alfkoehn/CO2_monitor/CO2_monitor.pdf

# A CO2 monitor as an introductory microelectronics project helping to slow-down the spread of the corona virus and ensuring a healthy learning and working environment

### A. Köhn-Seemann, alf.koehn@gmail.com

2021-01-27

Abstract

This paper describes the setup of a simple yet reliable CO2 monitor which is based on open-source microelectronics hardware. The monitor is intended to be used in class rooms, lecture halls or offices and can be constructed as a joint students project. It was motivated by recent discussions on the role of aerosols being part of exhaled air to spread the corona virus. The aerosol concentration in air is correlated with the CO2 concentration. Measuring the latter can thus help to slow-down the spread of the corona-virus. The program code used for the CO2 monitor and this documentation is available as a GitHub repository to allow for updates and improvements.

First full version released on 2020-09-22.

License for this document: CC BY-SA 4.0 (https://creativecommons.org/licenses/by-sa/4.0/)

## 1 Introduction

It is generally accepted that the CO2 concentration in a class room has an influence on students’ activities, their ability to study and learn [1, 2], or on their health and thus attendance [3]. The same applies of course to office environments [4]. The major source of CO2 in a class room is the exhaled air of the students (and teachers) [5]. It thus increases over time but can also be relatively easy controlled by proper ventilation. Monitoring

1

the CO2 concentration over time provides thus a simple way to ensure a productive and healthy learning environment.
In addition to CO2 , exhaled air consists of aerosols (among other things). It is now generally accepted that the aerosols of patients being infected with SARS-CoV-2, might contain viable virus concentrations which are large enough to cause further infections if somebody else inhales those aerosols [6– 9]. Note that this seems to happen even if the infected patients show no symptoms of SARS-CoV-2 [10] or not yet any symptoms [11]. It is thus not surprising that the vast majority of SARS-CoV-2 virus transmissions seems to happen indoors [12] and that closing schools and universities, for example, were found to have a significant effect on the spread of the virus [13]. Face masks can help to reduce the aerosol outflow and thus also slow down the infection rates [14, 15].
With half-life periods of the virus on aerosols on the order of 1 hour [16], it becomes evident that proper ventilation, strongly reducing the aerosol concentration, can help to prevent hidden infections, i.e. infections where the infected person is not (yet) aware of their infection but already contagious. This is further stressed by a case study from a seafood market in south China [17], a restaurant also from China [18], or from a choir in the US [19]. Note that ventilation was already recommended as a proper measure against the spread of a different pandemic, the Spanish flu, more than 100 years ago [20].
Since aerosols and CO2 are both parts of exhaled air, measuring the CO2 concentration in a room provides an easy accessible indicator for the aerosol concentration [21, 22]. In recent recommendations from national authorities, it was suggested to use the CO2 concentration as an indicator when ventilation is required [23–25]. A relevant example for the positive effect of proper ventilation based on the CO2 concentration in a room is the stopping of a tuberculosis outbreak at the Taipei University in Taiwan: only after the air circulation in every room was improved such that the CO2 concentration stayed around 600 ppm (the outdoor value is approximately 400 ppm), the outbreak came to a halt and stopped completely [26].
While commercial CO2 monitors do exist [27–29], these might be considered too expensive for usage in large quantities in schools or universities and/or currently have long delivery times (since their potential help in slowing down the spread of the SARS-CoV-2 virus seems to become more and more accepted). Here we present a simple and cost effective, yet reliable way to monitor the CO2 concentration. Widely available microelectronic components are used which can be easily programmed via open source software platforms allowing to modify and extend the examples presented in this paper. Students can build the detectors in class as a joint project which might

2

serve to raise interest in electronics or the underlying physical and chemical processes [30].
This work was inspired by a project of the Hochschule Trier [31], where the design and construction of a CO2 measuring device is suggested as a students’ project, allowing to discuss a variety of scientific topics during the course of the project. In addition, a few posts from different forums served as an inspiration [32–35]. Furthermore, a small number of projects hosted and maintained as GitHub repositories and webpages using the same CO2 detector are available [36–39]. We would like to recommend the interested reader in particular to the repository by paulvha [38] as it contains a rather large number of examples and to an article published in the Make Magazin [40] which contains a full description including the assembly of a CO2 monitor similar to the one presented in this paper.

## 2 The CO2 monitor

The CO2 monitor is based on the microelectronic sensor SCD30 which measures the CO2 concentration and also provides measurements of the ambient temperature and relative humidity [41]. Using Arduino as a programing language and some microcontroller, it is straightforward to get the sensor running and outputting data, thanks to the examples available in the libraries provided by SparkFun [42]. Using the Arduino IDE [43], which is available for all major operating systems, the corresponding libraries can be simply included via the library manager.
To make the CO2 monitor visually appealing, we decided to output the measurement to an OLED display (which is inexpensive and available in a large variety of sizes and configurations). Due to the widespread usage of such displays, they can also be directly included via the library manager in the Arduino IDE. Alternatively, an LCD display can be used which has the advantage of being larger in diameter but having a reduced resolution at a similar price. Note that we recommend to use LCD-displays with I2Cmodules to make the wiring and/or soldering less complicated (connecting 4 cables instead of 16).
In addition to just showing some numbers, we have included a red LED at the prototype installation which lights up as soon as some threshold value of the CO2 concentration is reached, indicating the need for ventilation. One could also think of a traffic light design, where first a yellow LED lights up at a slightly lower threshold value. The Federation of European Heating, Ventilation and Air Conditioning associations (REHVA) recommends to issue a warning, corresponding to an orange light, when a value of 800 ppm is

3

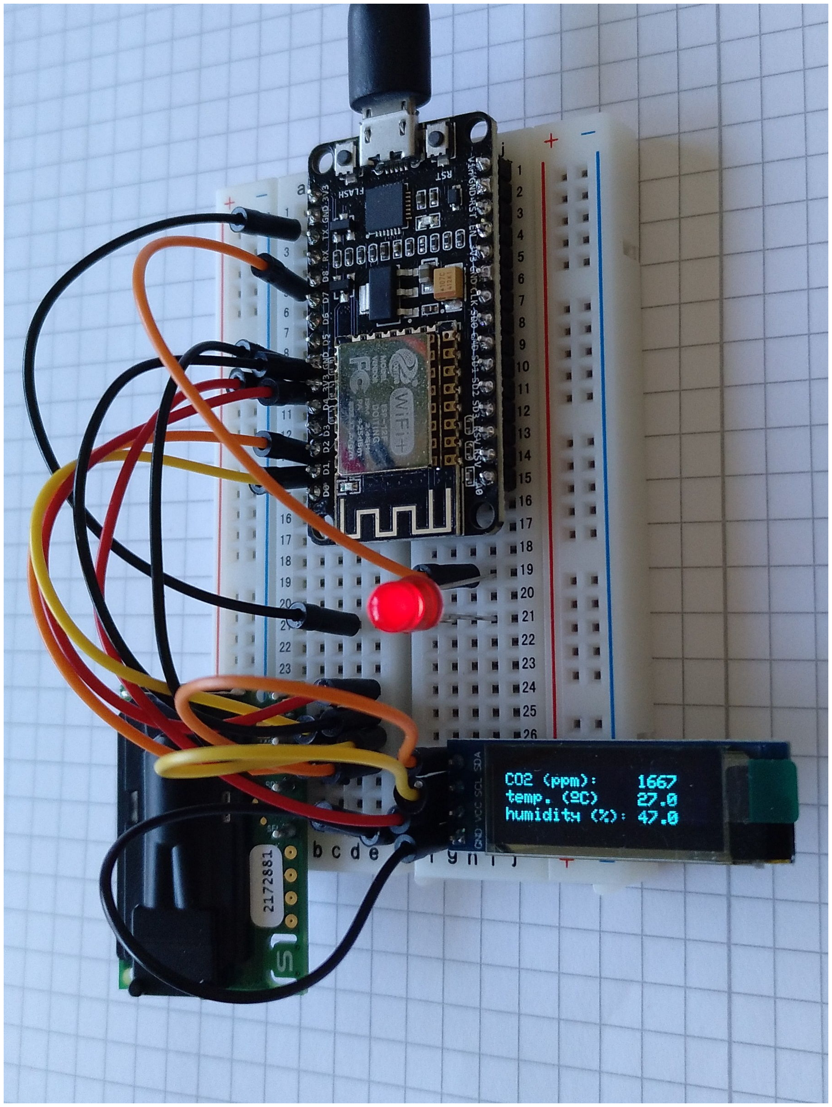
[picture p1: figure]
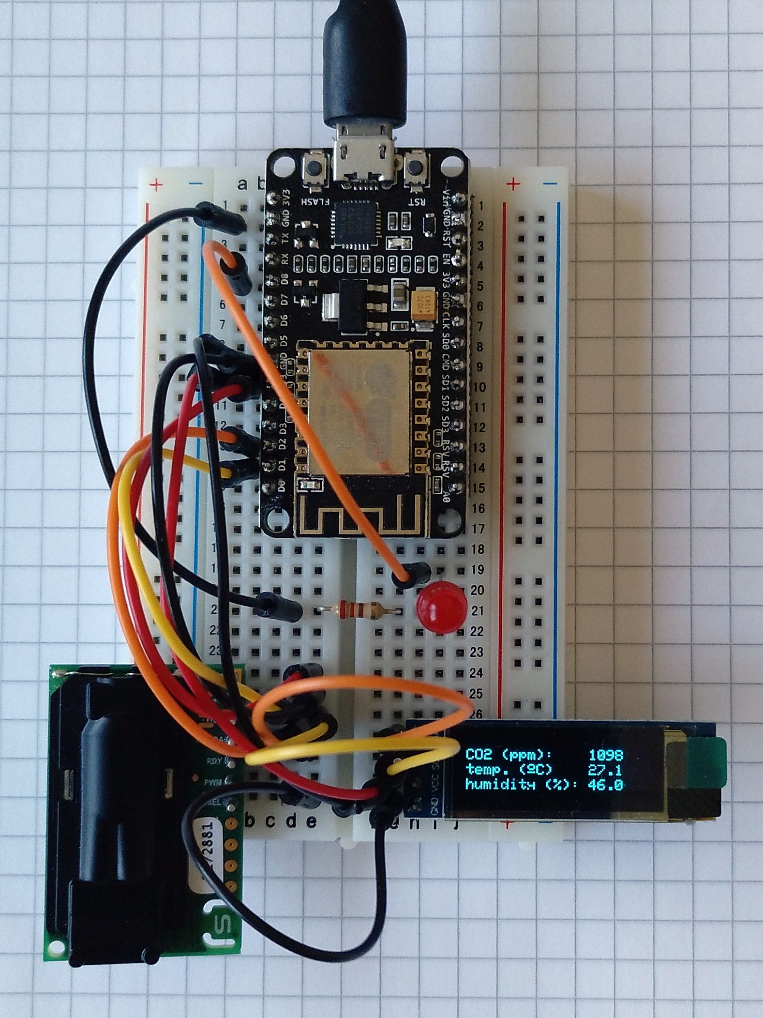
[picture p2: figure]

Figure 1: Assembled and working prototype of the CO2 monitor, (left) with a measured CO2 concentration below the threshold and (right) above it (note the red LED).

reached and prompt to trigger some action like ventilation, corresponding to a red light, when 1000 ppm are reached [44]. The Federal Ministry of Labour and Social Affairs of Germany also states a threshold value of 1000 ppm that should not be passed [45]. Note that a value of approximately 410 ppm is the typical CO2 concentration of fresh air [46].
As a microcontroller we decided to use the low-cost open source NodeMCU ESP8266 board [47], as it offers enough flexibility to further extend the functionality of the CO2 monitor. Of particular interest might be the WiFi capability allowing for example to write the measured values to a web-server where they can then be accessed via a web-browser or an app on a smartphone.
A prototype of the CO2 monitor is shown in Fig. 1. As one can see, it is not enclosed in some box to still allow easy access for modifications. The idea of this prototype was rather to show that the general principle of the CO2 monitor is working and not to provide a polished final product. The prototype is ready to be used in a class room or lecture hall, although it might be worth to mount everything into a box which is not only visually more appealing but provides also some protection.
As a next step one might want to replace the breadboard by a stripboard which of course requires some soldering but results in a more robust device.

4

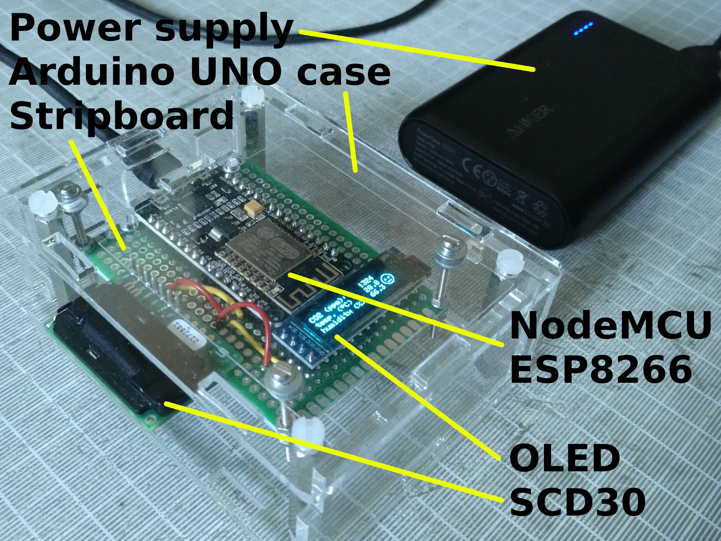
[picture p3: figure]

Figure 2: Assembled CO2 monitor, version 2. Note the usage of a stripboard and a casing originally designed for an Arduino Uno. In addition to the actual value, the CO2 concentration is indicated by the happiness of a smiley face shown next to the numbers on the OLED display.

Instead of designing a case for the CO2 monitor, it is possible to use cases which were originally designed for a Raspberry Pi or an Arduino Uno. Furthermore, the LEDs as an indicator for the level of the CO2 concentration can be replaced by a smiley face on the OLED display whose happiness correlates with the CO2 concentration: a higher level results in a more sad face. Figure 2 shows a photography of such an assembly, referred to as CO2 monitor version 2. More details about different assembly variations are discussed in Section 5.

### 2.1 Positioning in a room

The CO2 monitor should be placed at a position in a room where it is not exposed to flowing air as this would distort the measured CO2 concentration (see Section 4). This means that it should, for example, not be placed inbetween a window and a door if both are used for efficient cross ventilation¹ .

1Altough cross ventilation is more efficient than impact ventilation (“querlüften” vs. “stoßlüften” [48]) one has to take care that behind the open door in Fig. 3 another open window is needed otherwise one could release part of the classroom air and its potentially

5

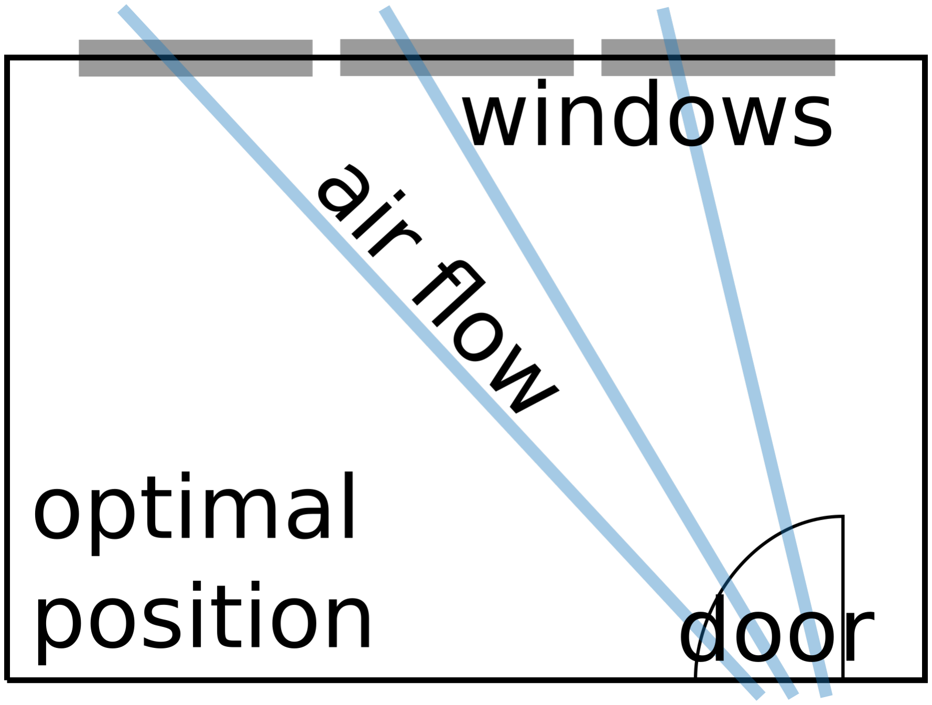
[picture p4: figure]

Figure 3: Optimal position of the CO2 monitor in a room where ventilation by an air flow across the room (cross ventilation) can be applied.

Figure 3 indicates the optimal positioning in such a situation. It should also not be positioned too close to the students’ or teachers’ heads as they could temporarily trigger very high values being displayed on the CO2 monitor if directly exhaling onto it. A position slightly above everybody’s head seems to be best as this would also allow everybody to have a look at it. The latter fact could in principle lead to some students’ closely following every change on the CO2 monitor instead of paying attention to the class or lecture. An easy solution would be to show only CO2 concentrations rounded to 100 ppm, for example print “CO2 in 100 ppm: 8” to a display [49].
Also be aware that classrooms and lecture halls often provide only a small number of wall sockets. One would thus need either a long enough power cable or a power bank (USB charger) which can also be included in the case of the CO2 monitor itself.

## 3 Required parts

The CO2 monitor as presented here consists of a number of parts for which it is not important to use the exact same model. The only component which should not be replaced is the CO2 measuring device, the SCD30. Note that the program code discussed in Sec. 6 is tailored for the NodeMCU ESP8266, replacing that component would thus require small adjustments to the code. The parts used for the prototype of the CO2 monitor are listed in Table 3. The display can be easily replaced by an OLED of larger size. One could also

infectious aerosols into the corridor which connects different classrooms or lecture halls [49].

6

Element | Quantity Price
SCD30 (CO2 sensor) | 1 | 45 e
NodeMCU ESP8266 | 1 | 5 e
0.91⁰⁰ OLED display | 1 | 5 e
red LED | 1 | 0.2 e
220 Ω resistor | 1 | 0.1 e
mini breadboard | 1 | 4 e
breadboard cables | 10 | 4 e
pin header | 1 | 0.5 e
micro USB cable | 1 | 3 e

Table 1: Components used for the CO2 monitor as presented in this paper (note that the prices were obtained in 09/2020 and may vary).

use multiple displays, which would require to take care of proper addressing the displays and thus add a little bit of complexity to the code (and to the assembly).
The usage of a breadboard was motivated by educational purposes as this allows very easy assembly without the need to solder anything. It can, however, directly be replaced by a stripboard or completely omitted and use only cables or pin headers (which would require some soldering).
Note that the prices as listed in the table can be pushed down (significantly for some of the components) when ordering larger quantities.
For the prototype design of the CO2 monitor we have decided to leave out a proper casing. One could either use a standard-sized case, or design one and print it for example on a 3D printer or re-use/recycle some old boxes. It is however important to correctly position the SCD30 inside the box: as described in a manufacturer’s document [50], the sensor is ideally placed as close as possible to the box’s outer shell and to a large opening to be properly exposed to the ambient. The box should be as small as possible to get fast response times to changes in the ambient air. The SCD30 should also be isolated from direct air flow, as the corresponding changes in pressure (due to the air flow) would lead to increased noise and thus reduced accuracy in the measurements. It is also recommended to not directly place the sensor above heat sources like for example microcontrollers.

## 4 The CO2 sensor

The SCD30 has been chosen because it performs direct measurements of the CO2 concentration. Cheaper sensors often measure the concentration

7

of volatile organic compounds (VOC) and then assume a correlation between the two quantities. This can, however, lead to wrong values of the CO2 concentration since VOC can be emitted from a variety of chemicals. Although VOCs are also known to cause health problems, here we are explicitly interested in the CO2 concentration, as discussed in Sec. 1. For a discussion about monitoring VOC and CO2 concentration with self-assembled devices we would like to point the interested reader to e.g. Ref. [51].

### 4.1 Technical specifications

According to the datasheet of the SCD30 [41], the CO2 sensor has a measurement range of 0−40, 000 ppm with an accuracy of ±30 ppm. The supply voltage needs to be between 3.3 and 5 V which allows to use a variety of microcontrollers. The drawn current is specified to be on average 19 mA with a maximum value of 75 mA. With a sensor lifetime of 15 years, the SCD30 offers a reliable system to permanently monitor the CO2 concentration.

### 4.2 Nondispersive infrared technique

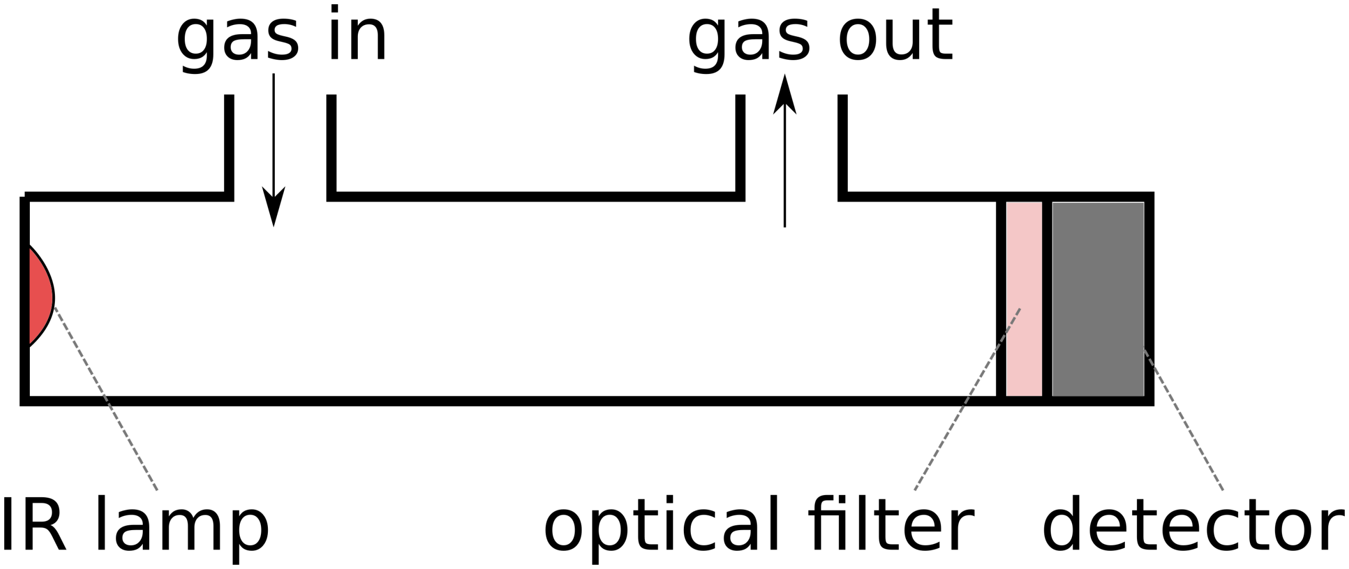
[picture p5: figure]

Figure 4: Sketch of a sensor using the nondispersive infrared technique to measure CO2 concentration.

The CO2 concentration is measured using the so-called nondispersive infrared technique (NDIR) which is the most common sensor type used in industry to measure the CO2 concentration [52–54]. Its principle is sketched in Fig. 4. A light source (a light bulb is used here) emits infrared light which travels through a tube filled with a sample of the surrounding air. The spectrum of the emitted light includes the 4.26 µm absorption band of CO2 which is unique to the typical components of air and the light is absorbed by them. At the end of the tube, the remaining light hits an optical filter that allows only that specific wavelength of 4.26 µm to pass. A CMOS detector then collects the remaining light and measures its intensity I1. The difference

8

between the intensity of light emitted by the source I0 and received by the detector at this specific wavelength is due to the CO2 molecules in the tube which then allows to calculate the CO2 concentration using the Beer-Lambert law:
I1 = I0e

−κCl
, | (1)

where κ is the absorption coefficient of CO2 , C its concentration, and l the length of the tube. A second tube without the optical filter in-front of the CMOS detector is used as a reference tube to compensate variations of I0. Using folded optics, i.e. waveguides, for the tube allows for a very compact size of the overall sensor on the order of just a few centimeters.

### 4.3 Calibration

The SCD30 is sold as a fully calibrated sensor and thus requires in principle no calibration before its usage. According to the manual [55], the sensor is set to automatically perform a self-calibration. This requires, however, to expose the sensor to fresh air on a regular basis. In particular during the first 7 days of operation, it has to be exposed to fresh air for one hour every day [55]. Since this is a requirement which is unrealistic to fulfill for our use case, we decided to follow a different approach: instead of the automatic self-calibration (ASC), a forced recalibration (FRC) can be performed after triggering it by the user. According to our observations, the SCD30 shows only very little drift over time, such that an FRC is only required once or twice per year (or after installing the SCD30 sensor into some device as it might have experienced some mechanical stress).
To perform the FRC, the CO2 monitor simply needs to be placed outside somewhere where it is exposed to fresh air. Note that the sensor itself should not experience strong winds as this would deteriorate the measurements. The whole sensor should be in thermodynamic equilibrium before starting the FRC so it is best to operate it for a time of approximately 10 min before starting the FRC (for more details about the code, see Section 6).

## 5 Assembly

The CO2 monitor can be assembled in various ways, first we will restrict ourselves to the case of a simple prototype design on a breadboard as shown in Fig. 5. The connection between the NodeMCU (with the ESP8266) and the SCD30 sensor is as follows:

9

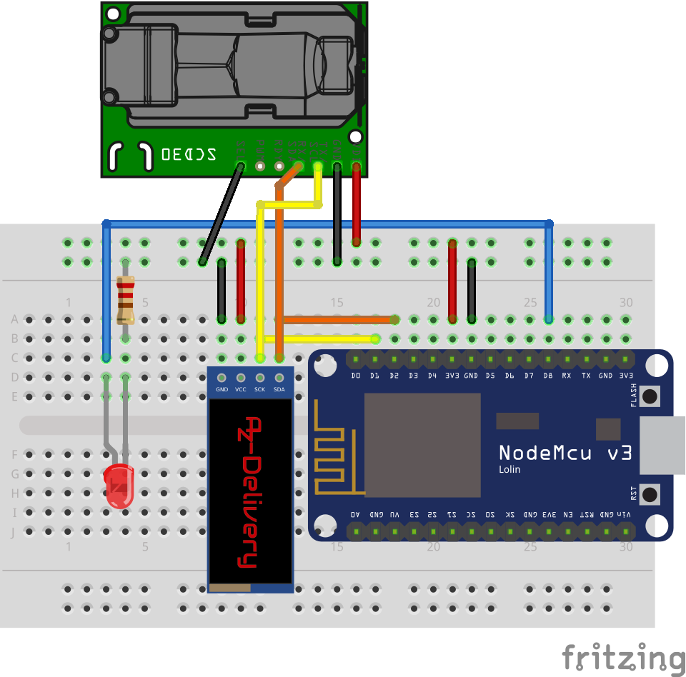
[picture p6: figure]

Figure 5: Schematic of a prototype of the CO2 monitor (version 1).

NodeMCU | SCD30
GND | −→ GND
3.3 V −→ VIN
D2/GPIO4 −→ RX/SDA
D1/GPIO5 | −→ TX/SCL
GND | −→ SEL

The NodeMCU ESP8266 board then needs to be connected to the OLED display as follows:

NodeMCU | OLED display
GND | −→ GND
3.3 V −→ VCC
D2/GPIO4 −→ SDA
D1/GPIO5 −→ SCL

It is of course also possible to directly connect the respective SDA and SCL pins of the OLED and the SCD30, as shown in Fig. 5, instead of connecting those pins between the SCD30 and the NodeMCU. The red LED is connected with its anode, the longer leg, to pin D8/GPIO15 of the NodeMCU and with its cathode, the shorter leg, via a 220 Ω resistor (to limit the current) to ground.
As discussed in Section 2, different assemblies of the CO2 monitor are

10

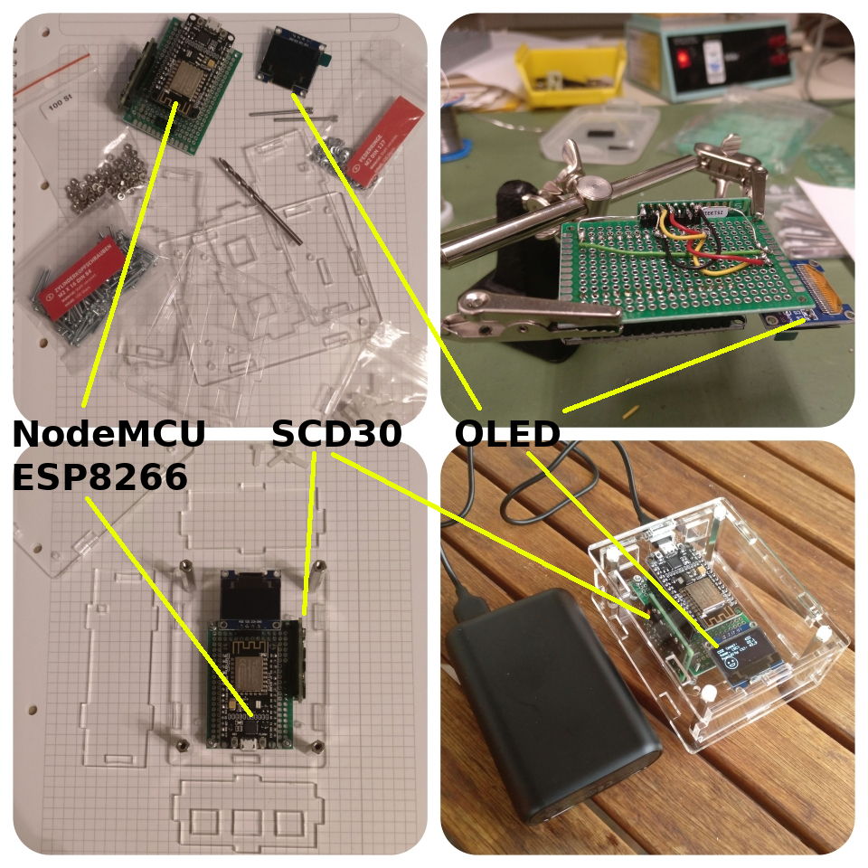
[picture p7: figure]

Figure 6: CO2 monitor, version 3, in various stages of the assembly process. As compared to version 2, see Fig. 2, a larger OLED display is used, the SCD30 is mounted in a different way, and a slightly smaller stripboard is used.

possible. Figure 6 shows what we refer to as version 3 in various stages of the assembly process. Compared to version 2, a larger OLED display is used, which requires to updates its size at the beginning of the program code, see Listing 3. As can be seen, the breadboard from version 1 is replaced by a stripboard onto which the necessary components need to be soldered. The casing is the same as in version 2 (which was originally intended to be used for an Arduino Uno). The side wall closest to the SCD30 has been omitted to ensure that the gas atmosphere inside the casing is the same as outside (a few holes drilled into that wall should have had the same effect). A portable battery charger, a power bank, is used as a power supply allowing for mobile usage of the CO2 monitor across the day.
A different assembly is shown in Fig. 7, where a picture frame and an

11

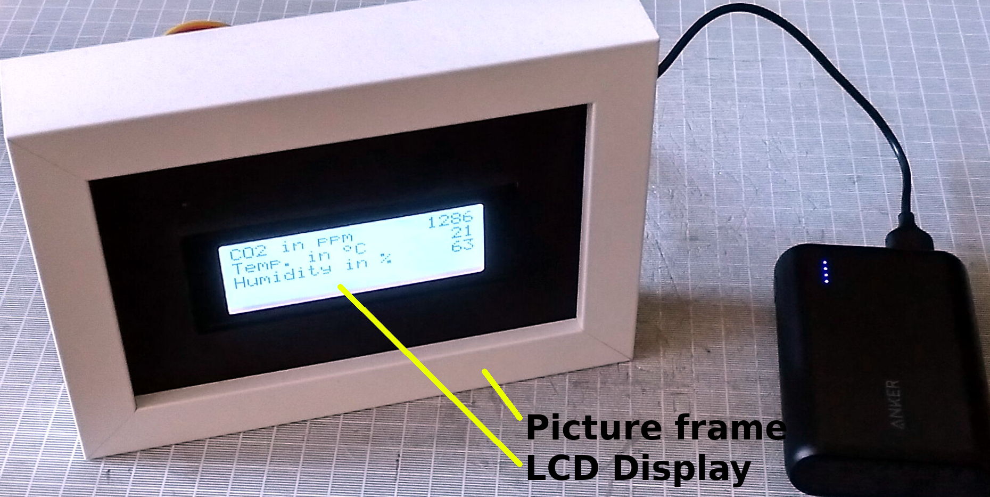
[picture p8: figure]

Figure 7: CO2 monitor, version 4. As compared to version 2 and 3, see Figs. 2 and 6, an LCD display is used which and mounted in a picture frame which allows to hide the other electronics due to its thickness of several centimeters.

4-row LCD display is used. The picture frame comes at a price of approximately 2 e and the LCD display is available at this size for approximately 10 e. The thickness of the picture frame allows to mount the other electronic components in it resulting in a visually appealing device. The finite thickness also allows to simply put the picture frame on a table/desk (or any other flat surface).

## 6 The program code

Arduino is used as programming language in this project due to its widespread usage and large numbers of libraries available for various hardware components. The Arduino IDE library manager allows to directly install a proper Arduino library for the SCD30. Alternatively, the library is available as a GitHub repository [42]. For a tutorial on how to install libraries within the Arduino IDE, see Ref. [56]. As for the NodeMCU and the OLED display, the Arduino IDE library manager is able to provide the required libraries. The source code for the CO2 monitor as described in this paper is available on GitHub [57], in order to be able to update and extend it. Nevertheless, we have also included the code in this paper, to provide a complete description of the project. At the very beginning of the code, some switches are set defining the general behavior of the program, as can be seen in Listing 1.

1 | // - - - - - - - - - - - - - - - - - - - - - - - - - - - - - - - - - - - - - - - - - - - - - - - - - - - - - - - - - - - - - - - - - - -
2 | // Some switches defining general behaviour of the program
3 | // - - - - - - - - - - - - - - - - - - - - - - - - - - - - - - - - - - - - - - - - - - - - - - - - - - - - - - - - - - - - - - - - - - -

12

4 | # define WIFI_ENABLED false | // set to true if WiFi is desired ,
5 | // otherwise c or re spo nd in g code is not
compiled
6 | #if WIFI_ENABLED
7 | # define WIFI_WEBSERVER true | // website in your WiFi for data and data
logger
8 | # define WIFI_MQTT false | // activate MQTT integration in your WiFi
9 | # endif
10 | # define DEBUG true | // activate debugging
11 | // true : | print info + data to serial
monitor
12 | // false : serial monitor is not used
13 | # define DISPLAY_OLED | // OLED display
14 | //# define DISPLAY_LCD | // LCD display
15 | # define SEND_VCC false
16 | // - - - - - - - - - - - - - - - - - - - - - - - - - - - - - - - - - - - - - - - - - - - - - - - - - - - - - - - - - - - - - - - - - - -
Listing 1: General behavior of the program is set via some switches.

The include statements to import the required libraries are shown in Listing 2. The Adafruit GFX.h and Adafruit SSD1306.h libraries are used for an OLED display (if one is connected) and are required to be installed via the library manager of the Arduino IDE beforehand (alternatively, they are also available on GitHub [58] for manual installation). The LiquidCrystal I2C.h library is used for the LCD display (if one is connected) and is also required
to be installed via the library manager (or directly from GitHub [59]). Note that the OLED and/or LCD display size needs to be set correctly and can vary. The SparkFun SCD30 Arduino Library.h also needs to be installed via the library manager (or manually from the GitHub repository [42]).
1 | // - - - - - - - - - - - - - - - - - - - - - - - - - - - - - - - - - - - - - - - - - - - - - - - - - - - - - - - - - - - - - - - - - - -
2 | // Import all required libraries
3 | // - - - - - - - - - - - - - - - - - - - - - - - - - - - - - - - - - - - - - - - - - - - - - - - - - - - - - - - - - - - - - - - - - - -
4 | # include < Wire .h > | // for I2C c om mu nic at io n
5 | # ifdef DISPLAY_OLED
6 | # include < Adafruit_GFX .h > | // for writing to display
7 | # include < Adafruit_SSD1306 .h > | // for writing to display
8 | # endif
9 | # ifdef DISPLAY_LCD
10 | # include < LiquidCrystal_I2C .h >
11 | # endif
12 | # include " SparkFun_SCD30_Arduino_Library .h"

13
14 | # include < ESP8266WiFi .h > | // also allows to explicitely turn WiFi
off
15 | #if WIFI_ENABLED
16 | #if WIFI_WEBSERVER
17 | # include < Hash .h > | // for SHA1 algorith ( for Font Awesome )
18 | # include < ESPAsyncTCP .h >
19 | # include < ESPAsyncWebServer .h >

20
21 | # include " Webpageindex .h" | // webpage content , same folder as . ino
file
22 # endif

23
24 #if WIFI_MQTT

13

25 | # include < PubSubClient .h > | // allows to send and receive MQTT
messages

26
27 | // add local MQTT server IP here .
28 | IPAddress mqttserver (192 , 168 , 1, 100) ;
29 | # endif
30 | // Replace with your network credentials
31 | const char * ssid | = " ENTER_SSID ";
32 | const char * password | = " ENTER_PASSWORD ";
33 | const char * deviceName = " ENTER_ESP_DEVICE_NAME ";
34 | # endif
35 | // - - - - - - - - - - - - - - - - - - - - - - - - - - - - - - - - - - - - - - - - - - - - - - - - - - - - - - - - - - - - - - - - - - -
Listing 2: Load required libraries.

A switch is included in the header of the code allowing to enable or disable WiFi capabilities (by setting the variable WIFI ENABLED respectively to true or false). The libraries required for using WiFi are only included if the corresponding switch is set to true. In this example, we decided to use the ESPAsyncWebServer [60], based on ESPAsyncTCP [61], for a webserver supposed to run on the ESP8266 because asynchronous networks, as provided by these two libraries, allow us to handle more than just one connection at a time (which is important if used in a classroom environment). During the time of writing this article, these libraries require manual installation, i.e. getting a zip file from the GitHub repositories and include those zip files manually as libraries in the Arduino IDE.
Hardware configurations, including the size of the display used, and some global constants are set after the include statements, as shown in Listing 3.
1 | // - - - - - - - - - - - - - - - - - - - - - - - - - - - - - - - - - - - - - - - - - - - - - - - - - - - - - - - - - - - - - - - - - - -
2 | // Hardware c o n f i g u r a t i o n s and some global constants
3 | // - - - - - - - - - - - - - - - - - - - - - - - - - - - - - - - - - - - - - - - - - - - - - - - - - - - - - - - - - - - - - - - - - - -
4 | # define CO2_THRESHOLD1 600
5 | # define CO2_THRESHOLD2 1000
6 | # define CO2_THRESHOLD3 1500

7
8 | # define WARNING_DIODE_PIN D8 | // NodeMCU pin for red LED

9
10 | # define MEASURE_INTERVAL 10 | // seconds , minimum : 2

11
12 | # define SCREEN_WIDTH 128 | // OLED display width in pixels
13 | # define SCREEN_HEIGHT 32 | // OLED display height in pixels

14
15 | const int lcdColumns | = 20; | // LCD : number of columns
16 | const int lcdRows | = 4; | // LCD : number of rows

17
18 | # define OLED_RESET LED_BUILTIN | // OLED reset pin , 4 is default
19 | | | // -1 if sharing Arduino reset pin
20 | | | // using NodeMCU , it is LED_BUILTIN

21
22 | const float TempOffset = 5; | // temperature offset of the SCD30
23 | | | // 0 is default value
24 | | | // 5 is used in SCD30 - library example
25 | | | // 5 also works for most of my devices

26

14

27 | const int altitudeOffset = 300; | // altitude of place of operation in
meters
28 | // Stuttgart : approx 300; Uni Stuttgart :
approx 500; Lohne : 67

29
30 | // update scd30 readings every M E A S U R E _ I N T E R V A L seconds
31 | const long interval = MEASURE_INTERVAL *1000;

32
33 | // use " unsigned long " for variables that hold time
34 | // | --> value will quickly become too large for an int
35 | // store last time scd30 was updated
36 | unsigned long previousMilliseconds = 0;

37
38 | // switch to perform a forced re ca li br at io n
39 | // should only be done once in a while and only when outside
40 | bool DO_FORCED_RECALIBRATION = false ;
41 | // - - - - - - - - - - - - - - - - - - - - - - - - - - - - - - - - - - - - - - - - - - - - - - - - - - - - - - - - - - - - - - - - - - -
Listing 3: Set some configurations.

Due to the complexity of the code, we decided to encapsulate certain parts in separate functions and use the technique of function prototyping and declaration. The function prototypes are shown in Listing 4.

1 | // - - - - - - - - - - - - - - - - - - - - - - - - - - - - - - - - - - - - - - - - - - - - - - - - - - - - - - - - - - - - - - - - - - -
2 | // Function prototypes ( not needed in Arduino , but good practice imho )
3 | // - - - - - - - - - - - - - - - - - - - - - - - - - - - - - - - - - - - - - - - - - - - - - - - - - - - - - - - - - - - - - - - - - - -
4 | void airSensorSetup () ;
5 | void forced_recalibration () ;
6 | void printToSerial ( float co2 , float temperature , float humidity );
7 | # ifdef DISPLAY_OLED
8 | void printToOLED ( float co2 , float temperature , float humidity );
9 | void printEmoji ( float value );
10 | # endif
11 | # ifdef DISPLAY_LCD
12 | void printToLCD ( float co2 , float temperature , float humidity ) ;
13 | void scrollLCDText ( int row , String message , int delayTime );
14 | # endif
15 | // - - - - - - - - - - - - - - - - - - - - - - - - - - - - - - - - - - - - - - - - - - - - - - - - - - - - - - - - - - - - - - - - - - -
Listing 4: Function prototypes.

Following the function prototypes, hardware declarations are executed, as shown in Listing 5.

1 | // - - - - - - - - - - - - - - - - - - - - - - - - - - - - - - - - - - - - - - - - - - - - - - - - - - - - - - - - - - - - - - - - - - -
2 | // Hardware declarations
3 | // - - - - - - - - - - - - - - - - - - - - - - - - - - - - - - - - - - - - - - - - - - - - - - - - - - - - - - - - - - - - - - - - - - -
4 | # ifdef DISPLAY_OLED
5 | // Declaration for an SSD1306 display connected to I2C (SDA , SCL pins )
6 | Adafruit_SSD1306 display ( SCREEN_WIDTH , SCREEN_HEIGHT , & Wire , OLED_RESET );
7 | # endif
8 | # ifdef DISPLAY_LCD
9 | // run I2C scanner if LCD address is unknown
10 | LiquidCrystal_I2C lcd (0 x27 , lcdColumns , lcdRows );
11 | # endif

12
13 | SCD30 airSensor ;
14 | // - - - - - - - - - - - - - - - - - - - - - - - - - - - - - - - - - - - - - - - - - - - - - - - - - - - - - - - - - - - - - - - - - - -

15

Listing 5: Hardware declarations.

To display the values measured by the SCD30 sensor on a website, we use global variables in the code, as shown in Listing 6. The complete html code for the website is loaded via including it as a library.

1 | #if WIFI_ENABLED
2 | // temperature , humidity , CO2 for web - page , updated in loop ()
3 | float temperature_web = 0.0;
4 | float humidity_web | = 0.0;
5 | float co2_web | = 0.0;

6
7 | #if WIFI_WEBSERVER
8 | // create A s y n c W e b S e r v e r object on port 80 ( port 80 for http )
9 | AsyncWebServer server (80) ;
10 | # endif
11 | #if WIFI_MQTT
12 | // declare ( initialize ) object of class WiFiClient (to establish
connection to IP/ port )
13 | WiFiClient espClient ;
14 | // declare ( initialize ) object of class PubSubClient
15 | // input : constructor of previously defined WiFiClient
16 | PubSubClient mqttClient ( espClient ) ;
17 | // message to be published to mqtt topic
18 | char mqttMessage [10];
19 | # endif
20 | # endif
Listing 6: Prepare website.

The code for the webpage itself is shown in Listing 7.

1 | //
2 | // PROGMEM stores data in flash memory , default is storing in SRAM
3 | // | --> usually , only worth to be used for large block of data
4 | // R infront of string indicates a RAW string literal
5 | // | --> no need to escape linebreaks , quotationmarks etc .
6 | // | --> allows to put full html - website into variable
7 | // | --> beginning and end of RAW string literal indicated by
8 | // | =====( ... ) =====
9 | //
10 | const char MAIN_page [] PROGMEM = R" =====(
11 | <! doctype html >
12 | <html >

13
14 | <head >
15 | <title >CO2 Monitor </ title >
16 | <!- - very helpful reference : https :// www . w3schools . com -->
17 | <meta charset ="utf -8">
18 | <!- - make webpage fit to your browser , not matter what OS or browser ( also
adjusts font sizes ) -->
19 | <meta name =" viewport " content =" width = device - width , initial - scale =1">
20 | <!- - prevent request on favicon , otherwise ESP receives favicon request
every time web server is accessed -->
21 | <link rel=" icon " href =" data :,">
22 | <!- - load Font Awesome , get integrity and url here : https :// fontawesome .
com / account / cdn -->

16

23 <link rel=" stylesheet " href =" https :// use . fontawesome . com / releases / v5 .14.0/ css / all . css " integrity ="sha384 - HzLeBuhoNPvSl5KYnjx0BT + WB0QEEqLprO + NBkkk5gbc67FTaL7XIGa2w1L0Xbgc " crossorigin =" anonymous ">
24 <!- - load chart .js library , this could also copied to esp8266 for usuage without internet connection -->
25 <script src = " https :// cdnjs . cloudflare . com / ajax / libs / Chart . js /2.7.3/ Chart . min . js" ></ script >
26 | <style >
27 | canvas {
28 | -moz -user - select : none ;
29 | -webkit -user - select : none ;
30 | -ms -user - select : none ;
31 | }
32 | html {
33 | font - family | : Arial ;
34 | display | : inline - block ;
35 | margin | : 0px auto ;
36 | text - align | : center ;
37 | }

38
39 | /* data table styling */
40 | # dataTable {
41 | font - family | : " Trebuchet MS", Arial , Helvetica , sans - serif ;
42 | border - collapse : collapse ;
43 | width | : 100%;
44 | }
45 | # dataTable td , # dataTable th {
46 | border | : 1px solid # ddd ;
47 | padding | : 8px;
48 | }
49 | # dataTable tr:nth - child ( even ){
50 | background - color : # f2f2f2 ;
51 | }
52 | # dataTable tr: hover {
53 | background - color : # ddd ;
54 | }
55 | # dataTable th {
56 | padding - top | : 12 px;
57 | padding - bottom | : 12 px;
58 | text - align | : left ;
59 | background - color : #4 CAF50 ;
60 | color | : white ;
61 | }
62 | </style >
63 | </head >

64
65 | <body >
66 | <div style ="text - align : center ;">
67 | <p style ="font - size :20 px">
68 | <b>CO <sub >2 </ sub > Monitor : data logger ( using Chart .js) </b>
69 | <button type =" button " onclick =" downloadData ()">Download data </ button >
70 | </p>
71 | <p>
72 | <i class ="fab fa - github " style ="font - size :1.0 rem ; color : black ;" ></i>
73 | <a href =" https :// github . com / alfkoehn / CO2_monitor " target =" _blank "
style ="font - size :1.0 rem ;"> Documentation & amp; code on GitHub </a>
74 | </p>
75 | <p>
76 | <i class ="fab fa - twitter " style ="font - size :1.0 rem ; color :#1 DA1F2 ;" ></i>
77 | <span style ="font - size :1.0 rem ;">Contact via twitter : </span >
78 | <a href =" https :// twitter . com / formbar " target =" _blank " style ="font - size
:1.0 rem ;" >&#64; formbar </a>

17

79 | </p>
80 | </div >
81 | <br >
82 | <div class ="chart - container " position : relative ; height :350 px; width :100% "
>
83 | < canvas id=" Chart1 " width =" 400" height ="400"> </ canvas >
84 | </ div >
85 | <br >
86 | <div class ="chart - container " position : relative ; height :350 px ; width :100% "
>
87 | <canvas id=" Chart2 " width =" 400" height ="400" ></ canvas >
88 | </div >
89 | <br >
90 | <div >
91 | <table id=" dataTable ">
92 | <tr >
93 | <th ><i class =" far fa - clock " ></i> Time </th >
94 | <th ><i class =" fas fa -head - side - cough " style =" color :# ffffff ;" ></i>
CO2 concentration in ppm </th >
95 | <th ><i class =" fas fa - thermometer - half " style =" color :# ffffff ;" > </i>
Temperaure in & deg ;C </th >
96 | <th ><i class =" fas fa - tint " style =" color :# ffffff ;" ></i> Humidity in
| % </th >
97 | </tr >
98 | </table >
99 | </div >
100 | <br >
101 | <br >

102
103 <script >

104
105 | // arrays for data values , will be dynamically filled
106 | // if length exceeds threshold , first ( oldest ) element is deleted
107 | var CO2values | = [];
108 | var Tvalues | = [];
109 | var Hvalues | = [];
110 | var timeStamp | = [];
111 | var maxArrayLength | = 1000;

112
113 | // update intervall for getting new data in milliseconds
114 | var updateIntervall = 10000;

115
116 | // Graphs visit : https :// www . chartjs . org
117 | // graph for CO2 concentration
118 | var ctx = document . getElementById (" Chart1 "). getContext ( ’2d ’);
119 | var Chart1 = new Chart (ctx , {
120 | type : ’line ’,
121 | data : {
122 | labels : timeStamp , | // Bottom Labeling
123 | datasets : [{
124 | label | : " CO2 concentration ",
125 | fill | : ’origin ’ , | // ’origin ’: fill area
| to x- axis
126 | backgroundColor : ’rgba ( 243 , 18 , 156 , .5) ’, // point fill color
127 | borderColor | : ’rgba ( 243 , 18 , 156 , 1) ’, | // point stroke color
128 | data | : CO2values ,
129 | }] ,
130 | },
131 | options : {
132 | title : {
133 | display | : false ,
134 | text | : " CO2 concentration "

18

135 | },
136 | maintainAspectRatio : false ,
137 | elements : {
138 | line : {
139 | tension | : 0.5 // Smoothening ( Curved ) of data lines
140 | }
141 | },
142 | scales : {
143 | yAxes : [{
144 | display | : true ,
145 | position | : ’left ’,
146 | ticks : {
147 | beginAtZero :false ,
148 | precision | : 0,
149 | fontSize | :16
150 | },
151 | scaleLabel : {
152 | display | : true ,
153 | // unicode for subscript : | u +208x,
154 | // | for superscript : u +207 x
155 | labelString : ’CO\ u2082 in ppm ’ ,
156 | fontSize | : 20
157 | },
158 | }]
159 | }
160 | }
161 | });
162 | // temperature and humidity graph
163 | var ctx2 = document . getElementById (" Chart2 "). getContext ( ’2d ’);
164 | var Chart2 = new Chart (ctx2 , {
165 | type : ’line ’,
166 | data : {
167 | labels : timeStamp , | // Bottom Labeling
168 | datasets : [{
169 | label | : " Temperature ",
170 | fill | : false , | // fill area to xAxis
171 | backgroundColor : ’rgba ( 243 , 156 , 18 , 1) ’, | // marker color
172 | borderColor | : ’rgba ( 243 , 156 , 18 , 1) ’, | // line Color
173 | yAxisID | : ’left ’,
174 | data | : Tvalues ,
175 | }, {
176 | label | : " Humidity ",
177 | fill | : false , | // fill area to xAxis
178 | backgroundColor : ’rgba (104 , 145 , 195 , 1) ’, | // marker color
179 | borderColor | : ’rgba (104 , 145 , 195 , 1) ’, | // line Color
180 | data | : Hvalues ,
181 | yAxisID | : ’right ’,
182 | }] ,
183 | },
184 | options : {
185 | title : {
186 | display | : false ,
187 | text | : " CO2 Monitor "
188 | },
189 | maintainAspectRatio : false ,
190 | elements : {
191 | line : {
192 | tension | : 0.4 | // smoothening ( bezier
| curve tension )
193 | }
194 | },
195 | scales : {

19

196 | yAxes : [{
197 | id | : ’left ’,
198 | position | : ’left ’,
199 | scaleLabel : {
200 | display | : true ,
201 | labelString : ’ Temperature in \ u00B0C ’,
202 | fontSize | : 20
203 | },
204 | ticks : {
205 | suggestedMin : 18 ,
206 | suggestedMax : 30 ,
207 | fontSize | : 16
208 | }
209 | }, {
210 | id | : ’right ’,
211 | position | : ’right ’ ,
212 | scaleLabel : {
213 | display | : true ,
214 | labelString : ’Humidity in %’,
215 | fontSize | : 20
216 | },
217 | ticks : {
218 | suggestedMin : 40 ,
219 | suggestedMax : 70 ,
220 | fontSize | : 16
221 | }
222 | }]
223 | }
224 | }
225 | });

226
227 | // function to dynamically updating graphs
228 | // much more efficient than replotting every time
229 | function updateCharts () {
230 | // update datasets to be plotted
231 | Chart1 . data . datasets [0]. data = CO2values ;
232 | Chart2 . data . datasets [0]. data = Tvalues ;
233 | Chart2 . data . datasets [1]. data = Hvalues ;
234 | // update the charts
235 | Chart1 . update ();
236 | Chart2 . update ();
237 | };

238
239 | // function to download data arrays into csv - file
240 | function downloadData () {
241 | // build array of strings with data to be saved
242 | var data = [];
243 | for ( var ii =0 ; ii < CO2values . length ; ii ++ ){
244 | data . push ( [ timeStamp [ii],
245 | Math . round ( CO2values [ii ]). toString () ,
246 | Tvalues [ii ]. toString () ,
247 | Hvalues [ii ]. toString ()
248 | ]);
249 | }

250
251 | // build String containing all data to be saved (csv - formatted )
252 | var csv = ’Time , CO2 in ppm , Temperature in Celsius , Humidity in percent \n
’;
253 | data . forEach ( function (row) {
254 | csv += row . join ( ’ , ’);
255 | csv += "\n";
256 | });

20

257
258 | // save csv - string into file
259 | // create a hyperlink element ( defined by <a> tag )
260 | var hiddenElement | = document . createElement ( ’a ’);
261 | // similar functions : encodeURI () , encodeURIComponent () ( escape () not
recommended )
262 | hiddenElement . href | = ’data : text / csv ; charset =utf -8 , ’+ encodeURI (csv );
263 | hiddenElement . target | = ’_blank ’;
264 | hiddenElement . download = ’CO2monitor .csv ’;
265 | hiddenElement . click ();
266 | };

267
268 // ajax script to get data repetivitely

269
270 | setInterval ( function () {
271 | // call a function repetitively , intervall set by variable <
updateIntervall >
272 | getData ();
273 | }, updateIntervall );

274
275 | function getData () {
276 | var xhttp | = new XMLHttpRequest ();

277
278 | // onreadystatechange property defines a function to be executed when
the readyState changes
279 | xhttp . onreadystatechange = function () {

280
281 | // " readyState " property holds the status of the " XMLHttpRequest "
282 | // | values : 0 | --> request not initialized
283 | // | 1 | --> server connection established
284 | // | 2 | --> request received
285 | // | 3 | --> processing request
286 | // | 4 | --> request finished and response is ready
287 | // " status " values : 200 --> "OK"
288 | // | 403 --> " Forbidden "
289 | // | 404 --> " Page not found "
290 | // " this " keyword always refers to objects it belongs to
291 | if ( this . readyState == 4 && this . status == 200) {
292 | // Push the data in array

293
294 | // Date () creates a Date object
295 | // toLocaleTimeString () returns time portion of Date object as
| string
296 | var time = new Date (). toLocaleTimeString ();

297
298 | // read - only XMLHttpRequest property responseText returns
299 | // text received from a server following a request being sent
300 | var txt = this . responseText ;

301
302 | // data from webserver is always a string , parsing with JSON . parse ()
303 | // to let data beome a JavaScrip object
304 | var obj = JSON . parse (txt);

305
306 | // add elements to arrays
307 | // push () methods adds new items to end of array , returns new length
308 | CO2values . push ( obj. COO );
309 | Tvalues . push (obj . Temperature );
310 | Hvalues . push (obj . Humidity );
311 | | timeStamp . push ( time );

312
313 | // if array becomes too long , delete oldest element to not overload
| graph

21

314 | // also delete first row of data table
315 | if ( CO2values . length > maxArrayLength ) {
316 | // shift () method to delete first element
317 | CO2values . shift ();
318 | Tvalues . shift ();
319 | Hvalues . shift ();
320 | timeStamp . shift ();

321
322 | // HTMLTableElement . deleteRow ( index ), index = -1 for last element
323 | document . getElementById (" dataTable "). deleteRow ( -1);
324 | }

325
326 | // update graphs
327 | updateCharts ();

328
329 | // update data table
330 | var table | = document . getElementById (" dataTable ");
331 | var row | = table . insertRow (1); // Add after headings
332 | var cell1 | = row . insertCell (0) ;
333 | var cell2 | = row . insertCell (1) ;
334 | var cell3 | = row . insertCell (2) ;
335 | var cell4 | = row . insertCell (3) ;
336 | cell1 . innerHTML = time ;
337 | cell2 . innerHTML = Math . round ( obj . COO );
338 | cell3 . innerHTML = obj . Temperature ;
339 | cell4 . innerHTML = obj . Humidity ;
340 | }
341 | };
342 | xhttp . open (" GET ", " readData ", true ); // Handle readData server on ESP8266
343 | xhttp . send ();
344 | }

345
346 | </ script >
347 | </body >
348 | </html >
349 | ) ===== ";
Listing 7: Code for the webpage.

As usual, the function declarations are all located at the end of the code but are briefly discussed first before coming to the main setup() and loop() functions. The function to print the data obtained from the SCD30 to the serial console is shown in Listing 8. Since it is possible to use an OLED and/or LCD display to show the measured data, a separate function for each case is included in the code, see Listing 9 and Listing 10

1 | void printToSerial ( float co2 , float temperature , float humidity ) {
2 | Serial . print (" co2 (ppm ):");
3 | Serial . print ( co2 , 1) ;
4 | Serial . print (" temp (C):");
5 | Serial . print ( temperature , 1) ;
6 | Serial . print (" humidity (%) :") ;
7 | Serial . print ( humidity , 1) ;
8 | Serial . println () ;
9 | }
Listing 8: Function which prints data to the serial console.

22

1 | # ifdef DISPLAY_OLED
2 | void printToOLED ( float co2 , float temperature , float humidity ) {
3 | int
4 | x0 , x1 ; | // to align output on OLED display vertically

5
6 | x0 | = 0;
7 | x1 | = 84;

8
9 | display . clearDisplay () ;
10 | display . setCursor (x0 ,5) ;
11 | display . print (" CO2 (ppm):");
12 | display . setCursor (x1 ,5) ;
13 | // for floats , 2nd parameter in display . print sets number of decimals
14 | display . print ( co2 , 0) ;

15
16 | display . setCursor (x0 ,15) ;
17 | display . print (" temp . ( C)") ;
18 | display . setCursor ( x0 +7*6 ,15) ;
19 | display . cp437 ( true ); | // enable full 256 char ’Code Page 437 ’ font
20 | display . write (248) ; | // degree symbol
21 | display . setCursor (x1 ,15) ;
22 | display . print ( temperature , 1) ;

23
24 | display . setCursor (x0 ,25) ;
25 | display . print (" humidity (%):");
26 | display . setCursor (x1 ,25) ;
27 | display . print ( humidity , 1) ;

28
29 | display . display () ;
30 | }
31 | # endif
Listing 9: Function which prints data to an OLED display.
1 | # ifdef DISPLAY_LCD
2 | void printToLCD ( float co2 , float temperature , float humidity ) {

3
4 | byte degreeSymbol [8] = {
5 | 0 b01100 , 0 b10010 , 0 b10010 , 0 b01100 ,
6 | 0 b00000 , 0 b00000 , 0 b00000 , 0 b00000
7 | };
8 | // allocate custom char to a location
9 | lcd . createChar (0 , degreeSymbol );

10
11 | // int waitTime | = 2000;
12 | lcd . clear () ;
13 | // DrawYoutube ();
14 | // delay ( waitTime );

15
16 | // print co2 c on ce nt rat io n (1 st line , i.e. row 0)
17 | lcd . setCursor (0 ,0) ;
18 | lcd . print ("CO2 in ppm ");
19 | // make output right - aligned
20 | lcd . setCursor ( ( lcdColumns - (int( log10 ( co2 )) +1) ) , 0) ;
21 | lcd . print ( int ( round ( co2 ) ));

22
23 | // print temperature (2 nd line , i.e. row 1)
24 | lcd . setCursor (0 ,1) ;
25 | lcd . print (" Temp . in ");
26 | lcd . write (0) ;

23

27 | lcd . print ("C");
28 | // make output right - aligned
29 | lcd . setCursor ( ( lcdColumns - (int( log10 ( temperature ) ) +1) ) , 1) ;
30 | lcd . print ( int ( round ( temperature )) );

31
32 | // print humidity (3 nd line , i.e. row 2)
33 | lcd . setCursor (0 ,2) ;
34 | lcd . print (" Humidity in %") ;
35 | // make output right - aligned
36 | lcd . setCursor ( ( lcdColumns - (int( log10 ( humidity )) +1) ) , 2) ;
37 | lcd . print ( int ( round ( humidity ) ));

38
39 | // delay ( waitTime );
40 | }
41 | # endif
Listing 10: Function which prints data to an LCD display.

Depending on the the CO2 concentration, the OLED display shows an
emoji with the level of happiness being correlated to the value of the CO2 concentration. The corresponding function to draw that face is given in Listing 11. For the
LCD display, a warning is shown if the CO2 concentration is too high, the corresponding code is shown in Listing 12.
1 | # ifdef DISPLAY_OLED
2 | void printEmoji ( float value ) {
3 | // syntax for functions used to draw to OLED :
4 | // display . drawBitmap (x, y , bitmap data , bitmap width , bitmap height ,
color )
5 // display . drawCircle (x, y , radius , color )

6
7 | float start_angle , | // used for smiley mouth
8 | | end_angle , | // used for smiley mouth
9 | | i; | // used for smiley mouth
10 | int | smile_x0 ,
11 | | smile_y0 ,
12 | | smile_r ,
13 | | emoji_r ,
14 | | emoji_x0 ,
15 | | emoji_y0 ,
16 | | eye_size ;

17
18 | emoji_r | = SCREEN_HEIGHT /4;
19 | if ( SCREEN_HEIGHT == 32) {
20 | emoji_x0 | = SCREEN_WIDTH - (1* emoji_r +1) ;
21 | emoji_y0 | = emoji_r *3 -1;
22 | eye_size | = 1;
23 | } else if ( SCREEN_HEIGHT == 64) {
24 | emoji_x0 | = emoji_r ;
25 | emoji_y0 | = emoji_r *3 -1;
26 | eye_size | = 2;
27 | }

28
29 | bool | plot_all ; | // if set , plots all emojis ( makes only sense for
larger oled )

30
31 | plot_all | = false ;
32 | if ( int ( value ) == 0) {
33 | plot_all | = true ;

24

34 }

35
36 | if ( value < CO2_THRESHOLD1 ){
37 | // very happy smiley face

38
39 | display . drawCircle ( emoji_x0 *1 , emoji_y0 , emoji_r , WHITE );

40
41 | start_angle = 20./180* PI ;
42 | end_angle | = 160./180* PI ;
43 | smile_r | = emoji_r /2;
44 | smile_x0 | = emoji_x0 *1;
45 | smile_y0 | = emoji_y0 + emoji_r /6;
46 | for (i = start_angle ; i < end_angle ; i = i + 0.05) {
47 | display . drawPixel ( smile_x0 + cos (i) * smile_r , smile_y0 + sin (i ) *
smile_r , WHITE );
48 | }

49
50 | display . drawLine ( smile_x0 + cos ( start_angle )* smile_r , smile_y0 + sin (
start_angle )* smile_r ,
51 | | smile_x0 + cos ( end_angle ) * smile_r , smile_y0 + sin ( end_angle
| )* smile_r ,
52 | | WHITE );

53
54 | // draw eyes
55 | display . fillCircle ( emoji_x0 *1 - emoji_r /2/4*3 , smile_y0 - emoji_r /3 ,
eye_size , WHITE );
56 | display . fillCircle ( emoji_x0 *1+ emoji_r /2/4*3 , smile_y0 - emoji_r /3 ,
eye_size , WHITE );
57 | }
58 | if (( value >= CO2_THRESHOLD1 && value < CO2_THRESHOLD2 ) || ( plot_all ==
| true )) {
59 | // happy smiley face

60
61 | if ( SCREEN_HEIGHT == 32) {
62 | display . drawCircle ( emoji_x0 , emoji_y0 , emoji_r , WHITE ) ;
63 | } else if ( SCREEN_HEIGHT == 64) {
64 | display . drawCircle ( emoji_x0 + 2* emoji_r , emoji_y0 , emoji_r , WHITE );
65 | }

66
67 | // draw mouth
68 | if ( SCREEN_HEIGHT == 32) {
69 | smile_x0 | = emoji_x0 ;
70 | } else if ( SCREEN_HEIGHT == 64) {
71 | smile_x0 | = emoji_x0 + 2* emoji_r ;
72 | }
73 | start_angle = 20./180* PI ;
74 | end_angle | = 160./180* PI ;
75 | smile_r | = emoji_r /2;
76 | smile_y0 | = emoji_y0 + emoji_r /6;
77 | for (i = start_angle ; i < end_angle ; i = i + 0.05) {
78 | display . drawPixel ( smile_x0 + cos (i) * smile_r , smile_y0 + sin (i ) *
smile_r , WHITE );
79 | }

80
81 | // draw eyes
82 | display . fillCircle ( smile_x0 - emoji_r /2/4*3 , smile_y0 - emoji_r /3 , eye_size ,
| WHITE );
83 | display . fillCircle ( smile_x0 + emoji_r /2/4*3 , smile_y0 - emoji_r /3 , eye_size ,
| WHITE );
84 | }
85 | if (( value >= CO2_THRESHOLD2 && value < CO2_THRESHOLD3 ) || ( plot_all ==
| true )) {

25

86 | // not so happy smiley face

87
88 | if ( SCREEN_HEIGHT == 32) {
89 | display . drawCircle ( emoji_x0 , emoji_y0 , emoji_r , WHITE ) ;
90 | } else if ( SCREEN_HEIGHT == 64) {
91 | display . drawCircle ( emoji_x0 + 4* emoji_r , emoji_y0 , emoji_r , WHITE );
92 | }

93
94 | // draw mouth
95 | if ( SCREEN_HEIGHT == 32) {
96 | smile_x0 | = emoji_x0 ;
97 | } else if ( SCREEN_HEIGHT == 64) {
98 | smile_x0 | = emoji_x0 + 4* emoji_r ;
99 | }
100 | display . drawLine ( smile_x0 - emoji_r /2/4*3 , emoji_y0 + emoji_r /2 ,
101 | | smile_x0 + emoji_r /2/4*3 , emoji_y0 + emoji_r /2 ,
102 | | WHITE );

103
104 | // draw eyes
105 | display . fillCircle ( smile_x0 - emoji_r /2/4*3 , smile_y0 - emoji_r /3 , eye_size ,
| WHITE );
106 | display . fillCircle ( smile_x0 + emoji_r /2/4*3 , smile_y0 - emoji_r /3 , eye_size ,
| WHITE );
107 | }
108 | if (( value >= CO2_THRESHOLD3 ) || ( plot_all == true )) {
109 | // sad smiley face

110
111 | if ( SCREEN_HEIGHT == 32) {
112 | display . drawCircle ( emoji_x0 , emoji_y0 , emoji_r , WHITE ) ;
113 | } else if ( SCREEN_HEIGHT == 64) {
114 | display . drawCircle ( emoji_x0 + 6* emoji_r -1 , emoji_y0 , emoji_r , WHITE );
115 | }

116
117 | // draw mouth
118 | if ( SCREEN_HEIGHT == 32) {
119 | smile_x0 | = emoji_x0 ;
120 | } else if ( SCREEN_HEIGHT == 64) {
121 | smile_x0 | = emoji_x0 + 6* emoji_r ;
122 | }
123 | start_angle = 200./180* PI ;
124 | end_angle | = 340./180* PI ;
125 | smile_r | = emoji_r /2;
126 | smile_y0 | = emoji_y0 + emoji_r /6;
127 | for (i = start_angle ; i < end_angle ; i = i + 0.05) {
128 | display . drawPixel ( smile_x0 + cos (i) * smile_r , smile_y0 + emoji_r /2 +
sin (i) * smile_r , WHITE );
129 | }

130
131 | // draw eyes
132 | display . fillCircle ( smile_x0 - emoji_r /2/4*3 , smile_y0 - emoji_r /3 , eye_size ,
| WHITE );
133 | display . fillCircle ( smile_x0 + emoji_r /2/4*3 , smile_y0 - emoji_r /3 , eye_size ,
| WHITE );
134 | }
135 | display . display () ;
136 | }
137 | # endif
Listing 11: Function which prints smileys to the OLED display depending on the value of the CO2 concentration.

26

1 | # ifdef DISPLAY_LCD
2 | // Parameters :
3 | // | row : | where text will be printed
4 | // | message : | text to scroll
5 | // | delayTime : | time between character shifting
6 | // inspired by https :// r a n d o m n e r d t u t o r i a l s . com / esp32 - esp8266 -i2c -lcd - arduino
- ide /
7 | void scrollLCDText ( int row , String message , int delayTime ){
8 | // add whitespaces equal to no . LCD - columns at beginning of string
9 | for (int i =0; i < lcdColumns ; ++ i) {
10 | message = " "+ message ;
11 | }
12 | message = message +" ";
13 | // emulate the scrolling by printing substrings sequentially
14 | for (int pos =0 ; pos < message . length () ; ++ pos ) {
15 | lcd . setCursor (0 , row ) ;
16 | lcd . print ( message . substring ( pos , pos + lcdColumns ));
17 | delay ( delayTime );
18 | }
19 | }
20 | # endif
Listing 12: Function which prints a warning to the LCD display depending on the value of the CO2 concentration.

Listing 13 shows the setup function of the code, where the serial monitor is initialized, followed by the diode, optionally the WiFi, the OLED display, and then the SCD30. Finally, the webserver and the functions required to update the data on the webpage are prepared.

1 | void setup () {
2 | if ( DEBUG == true ) {
3 | // initialize serial monitor at baud rate of 115200
4 | Serial . begin (115200) ;
5 | | delay (1000) ;
6 | Serial . println (" Using SCD30 to get : CO2 concentration , temperature ,
| | humidity ");
7 | }

8
9 | // initialize I2C
10 | | Wire . begin () ;

11
12 | // initialize LED pin as an output
13 | pinMode ( WARNING_DIODE_PIN , OUTPUT );

14
15 | #if WIFI_ENABLED
16 | | #if WIFI_MQTT
17 | // configure mqtt server details , after that client is ready
18 | // create connection to mqtt broker
19 | mqttClient . setServer ( mqttserver , 1883) ;
20 | | # endif
21 | /* Explicitly set ESP8266 to be a WiFi - client , otherwise , it would , by
22 | default , try to act as both , client and access - point , and could cause
23 | network - issues with other WiFi - devices on your WiFi - network . */
24 | WiFi . mode ( WIFI_STA );
25 | WiFi . begin ( ssid , password ); | // connect to Wi - Fi
26 | if ( DEBUG == true )
27 | Serial . println (" Connecting to WiFi ");
28 | while ( WiFi . status () != WL_CONNECTED ) {

27

29 | delay (1000) ;
30 | if ( DEBUG == true )
31 | Serial . print (".");
32 | }
33 | IPAddress ip = WiFi . localIP () ;
34 | if ( DEBUG == true )
35 | Serial . println ( ip );

36
37 | #if WIFI_WEBSERVER
38 | // - - - - - - - - - - - - - - - - - - - - - - - - - - - - - - - - - - - - - - - - - - - - - - - - - - - - - - - - - - - - - - - - - - -
39 | // This is executed when you open the IP in browser
40 | // - - - - - - - - - - - - - - - - - - - - - - - - - - - - - - - - - - - - - - - - - - - - - - - - - - - - - - - - - - - - - - - - - - -
41 | server . on ("/", HTTP_GET , []( AsyncWebServerRequest * request ) {
42 | // note : do NOT load MAIN_page into a String variable
43 | // | this might not work ( probably too large )
44 | request -> send_P (200 , " text / html ", MAIN_page );
45 | }) ;

46
47 | // this page is called by java Script AJAX
48 | server . on ("/ readData ", HTTP_GET , []( AsyncWebServerRequest * request ) {
49 | // putting all values into one big string
50 | // inspiration : https :// circuits4you . com /2019/01/11/ nodemcu - esp8266 -
arduino - json - parsing - example /
51 | String data2send = " {\" COO \":\" "+ String ( co2_web )
52 | +"\" , \" Temperature \":\" "+ String ( temperature_web )
53 | +"\" , \" Humidity \":\" "+ String ( humidity_web ) +" \"} "
;
54 | request -> send_P (200 , " text / plain ", data2send . c_str () );
55 | }) ;
56 | // - - - - - - - - - - - - - - - - - - - - - - - - - - - - - - - - - - - - - - - - - - - - - - - - - - - - - - - - - - - - - - - - - - -

57
58 | server . begin () ;
59 | # endif
60 | # else
61 | WiFi . mode ( WIFI_OFF ); | // explicitely turn WiFi off
62 | WiFi . forceSleepBegin () ; | // explicitely turn WiFi off
63 | delay ( 1 ); | // required to apply WiFi changes
64 | if ( DEBUG == true )
65 | Serial . println (" WiFi is turned off .");
66 | # endif

67
68 | # ifdef DISPLAY_OLED
69 | // S S D 1 3 0 6 _ S W I T C H C A P V C C : generate display voltage from 3.3 V internally
70 | if (! display . begin ( SSD1306_SWITCHCAPVCC , 0 x3C )) { // Address 0 x3C for 128
x32
71 | if ( DEBUG == true )
72 | Serial . println (F (" SSD1306 allocation failed ")) ;
73 | for (;;) ; | // don ’t proceed , loop forever
74 | }
75 | display . display () ; | // initialize display
76 | // library will show Adafruit logo
77 | delay (2000) ; | // pause for 2 seconds
78 | display . clearDisplay () ; | // clear the buffer
79 | display . setTextSize (1) ; | // has to be set initially
80 | display . setTextColor ( WHITE ); | // has to be set initially

81
82 | // move cursor to position and print text there
83 | display . setCursor (2 ,5) ;
84 | display . println ("CO2 monitor ");
85 | display . println (" twitter . com / formbar ");
86 | #if WIFI_ENABLED
87 | display . println ( ip );

28

88 | # else
89 | display . println (" WiFi disabled ");
90 | # endif

91
92 | // write previously defined emojis to display
93 | if ( SCREEN_HEIGHT == 32) {
94 | printEmoji (400) ;
95 | delay (2000) ;
96 | printEmoji (600) ;
97 | delay (2000) ;
98 | printEmoji (1200) ;
99 | delay (2000) ;
100 | printEmoji (1800) ;
101 | delay (2000) ;
102 | } else {
103 | printEmoji (0) ;
104 | }

105
106 | display . display () ; | // write display buffer to display
107 | # endif

108
109 | # ifdef DISPLAY_LCD
110 | lcd . init () ; | // initialize LCD
111 | lcd . backlight () ; | // turn on LCD backlight
112 | lcd . setCursor (0 ,0) ; | // set cursor to ( column , row )
113 | lcd . print (" WiFi connected ") ;
114 | lcd . setCursor (0 ,1) ;
115 | lcd . print ( ip );
116 | delay (2000) ;
117 | # endif

118
119 | // turn warning LED on and off to test it
120 | digitalWrite ( WARNING_DIODE_PIN , HIGH );
121 | delay (2000*2) ;
122 | digitalWrite ( WARNING_DIODE_PIN , LOW );

123
124 | // initialize SCD30
125 | airSensorSetup () ;
126 | }
Listing 13: General setup function.

The calibration and setup of the SCD30 is put into a separate function, shown in Listing 14. An additional function, given in Listing 15, performs the forced recalibration of the SCD30 discussed in Section 4.3.

1 void airSensorSetup () {

2
3 bool autoSelfCalibration = false ;

4
5 | // start sensor using the Wire port
6 | if ( airSensor . begin ( Wire ) == false ) {
7 | if ( DEBUG == true )
8 | Serial . println (" Air sensor not detected . Please check wiring . Freezing
| ... ");
9 | while (1)
10 | ;
11 | }

12
13 | // disable auto - calibration ( import , see full d oc um ent at io n for details )
14 | airSensor . setAutoSelfCalibration ( autoSelfCalibration );

29

15
16 | // SCD30 has data ready at maximum every two seconds
17 | // can be set to 1800 at maximum (30 minutes )
18 | // airSensor . s e t M e a s u r e m e n t I n t e r v a l ( M E A S U R E _ I N T E R V A L );

19
20 | // altitude compensation in meters
21 | // alternatively , one could also use :
22 | // | airSensor . s e t A m b i e n t P r e s s u r e ( p r e s s u r e _ i n _ m B a r )
23 | delay (1000) ;
24 | airSensor . setAltitudeCompensation ( altitudeOffset );

25
26 | float T_offset = airSensor . getTemperatureOffset () ;
27 | Serial . print (" Current temp offset : ");
28 | Serial . print ( T_offset , 2) ;
29 | Serial . println ("C");

30
31 | // note : this value also depends on how you installed
32 | // | the SCD30 in your device
33 | airSensor . setTemperatureOffset ( TempOffset ) ;
34 | }
Listing 14: Setup code for the SCD30.
1 | void forced_recalibration () {
2 | // note : for best results , the sensor has to be run in a stable
environment
3 | // | in continuous mode at a measurement rate of 2s for at least two
4 | // | minutes before applying the FRC command and sending the reference
value
5 // quoted from " Interface Description Sensirion SCD30 Sensor Module "

6
7 String counter ;

8
9 int CO2_offset_calibration = 410;

10
11 | if ( DEBUG == true ){
12 | | Serial . println (" Starting to do a forced recalibration in 10 seconds ");
13 | }

14
15 | # ifdef DISPLAY_OLED
16 | display . clearDisplay () ;
17 | display . setCursor (0 ,0) ;
18 | display . println (" Warning :");
19 | display . println (" forced recalibration ");
20 | display . display () ;

21
22 | for (int ii =0; ii <10; ++ ii ){
23 | | counter = String (10 - ii );
24 | | display . setCursor ( ii *9 ,20) ;
25 | | display . print ( counter );
26 | | display . display () ;
27 | | delay (1000) ;
28 | }
29 | # endif

30
31 airSensor . setForcedRecalibrationFactor ( CO2_offset_calibration );

32
33 | # ifdef DISPLAY_OLED
34 | delay (1000) ;
35 | display . clearDisplay () ;
36 | display . setCursor (0 ,0) ;

30

37 | display . println (" Successfully recalibrated !");
38 | display . println (" Only required ~ once per year ");
39 | display . display () ;
40 | # endif

41
42 | delay (5000) ;
43 | }
Listing 15: Function to perform a forced recalibration of the SCD30.

The main code, the loop function, is given in Listing 16. First, the data is obtained from the SCD30 sensor and then passed to a function outputting it to the serial monitor and then to another function, printing it on an OLED and/or LCD display. The data is then copied into the corresponding global variables to prepare the next update for the webpage. Finally, it is checked if the CO2 concentration is above a critical threshold: a red LED indicates too high a value in our example, in addition some reaction on the OLED/LCD display is shown (one could also think of an acoustic signal and some visual change on the webpage).

1 void loop () {

2
3 | float
4 | co2_new ,
5 | temperature_new ,
6 | humidity_new ;

7
8 unsigned long currentMilliseconds ;

9
10 | // get milliseconds passed since program started to run
11 | currentMilliseconds = millis () ;

12
13 | // forced re ca lib ra ti on requires 2 minutes of stable environment in
| advance
14 | if (( DO_FORCED_RECALIBRATION == true ) && ( currentMilliseconds > 120000) ) {
15 | forced_recalibration () ;
16 | DO_FORCED_RECALIBRATION = false ;
17 | }

18
19 | if ( currentMilliseconds - previousMilliseconds >= interval ) {
20 | // save the last time you updated the DHT values
21 | previousMilliseconds = currentMilliseconds ;
22 | #if SEND_VCC
23 | vdd = ESP . getVcc () ;
24 | # endif

25
26 | if ( airSensor . dataAvailable () ) {
27 | // get updated data from SCD30 sensor
28 | co2_new | = airSensor . getCO2 () ;
29 | temperature_new = airSensor . getTemperature () ;
30 | humidity_new | = airSensor . getHumidity () ;

31
32 | // print data to serial console
33 | if ( DEBUG == true )
34 | printToSerial ( co2_new , temperature_new , humidity_new );

35
36 | // print data to display

31

37 | # ifdef DISPLAY_OLED
38 | printToOLED ( co2_new , temperature_new , humidity_new );
39 | // print smiley with happiness according to CO2 c on ce nt rat io n
40 | printEmoji ( co2_new );
41 | # endif
42 | # ifdef DISPLAY_LCD
43 | printToLCD ( co2_new , temperature_new , humidity_new );
44 | if ( co2_new > CO2_THRESHOLD3 )
45 | scrollLCDText ( 3, " LUEFTEN ", 250 );
46 | # endif
47 | // if CO2 - value is too high , issue a warning
48 | if ( co2_new >= CO2_THRESHOLD3 ) {
49 | digitalWrite ( WARNING_DIODE_PIN , HIGH );
50 | } else {
51 | digitalWrite ( WARNING_DIODE_PIN , LOW );
52 | }
53 | #if WIFI_ENABLED
54 | // updated values for webpage
55 | co2_web | = co2_new ;
56 | temperature_web = temperature_new ;
57 | humidity_web | = humidity_new ;
58 | #if WIFI_MQTT
59 | // boolean connect ( clientID , [ username , password ])
60 | // see https :// pubsubclient . knolleary . net / api
61 | mqttClient . connect ( deviceName );
62 | #if SEND_VCC
63 | sprintf ( mqttMessage , "%d", vdd );
64 | // boolean publish ( topic , payload )
65 | // publish message to the specified topic
66 | mqttClient . publish ("esp -co2/ co2 / vcc ", mqttMessage );
67 | # endif
68 | mqttClient . publish ("esp -co2/ co2 / hostname ", deviceName );
69 | sprintf ( mqttMessage , " %6.2 f", co2_web );
70 | mqttClient . publish ("esp -co2/ co2 / co2 ", mqttMessage );
71 | sprintf ( mqttMessage , " %6.2 f", temperature_web ) ;
72 | mqttClient . publish ("esp -co2/ co2 / temp ", mqttMessage );
73 | sprintf ( mqttMessage , " %6.2 f", humidity_web );
74 | mqttClient . publish ("esp -co2/ co2 / hum ", mqttMessage );
75 | # endif
76 | # endif
77 | }
78 | }
79 | delay (100) ;
80 | }
Listing 16: Main loop which is executed repeatedly.

## Acknowledgments

The author is indebted to the efforts of the open-source software community.

## References

[1] D. Twardella, W. Matzen, T. Lahrz, R. Burghardt, H. Spegel,
L. Hendrowarsito, A. C. Frenzel, and H. Fromme. Effect of classroom air

32 quality on students’ concentration: results of a cluster-randomized crossover experimental study. Indoor Air, 22:378, 2012, doi:10.1111/j.1600-0668.2012.00774.x.

[2] S. Gaihre, S. Semple, J. Miller, S. Fielding, and S. Turner. Classroom Carbon Dioxide Concentration, School Attendance, and Educational Attainment. J. Sch. Health, 85:569–574, 2014, doi:10.1111/josh.12183.
[3] D. G. Shendell, R. Prill, W. J. Fisk, M. G. Apte, D. Blake, and
D. Faulkner. Associations between classroom CO2 concentrations and student attendance in Washington and Idaho. Indoor Air, 14:333, 2004, doi:10.1111/j.1600-0668.2004.00251.x.
[4] J. G. Allen, P. MacNaughton, U. Satish, S. Santanam, J. Vallarino, and
J. D. Spengler. Associations of Cognitive Function Scores with Carbon Dioxide, Ventilation, and Volatile Organic Compound Exposures in Office Workers: A Controlled Exposure Study of Green and Conventional Office Environments. Environmental Health Perspectives, 6:805, 2016, doi:10.1289/ehp.1510037.
[5] A. Persily and L. de Jonge. Carbon dioxide generation rates for building occupants. Indoor Air, 2017, doi:10.1111/ina.12383.
[6] J. A. Lednicky, M. Lauzardo, Z. Hugh Fan, A. S. Jutla, T. B. Tilly,
M. Gangwar, M. Usmani, S. N. Shankar, K. Mohamed, A. Eiguren-Fernandez, C. J. Stephenson, Alam. Md. M., M. A. Elbadry, J. C. Loeb, K. Subramaniam, T. B. Waltzek, K. Cherabuddi, J. G. Morris Jr., and C.-Y. Wu. Viable SARS-CoV-2 in the air of a hospital room with COVID-19 patients. medRxiv, 2020, doi:10.1101/2020.08.03.20167395.
[7] L. Morawska and D. K. Milton. It is Time to Address Airborne Transmission of COVID-19. Clinical Infectious Diseases, 2020, doi:10.1093/cid/ciaa939.
[8] M. A. Kohanski, L. J. Lo, and M. S. Waring. Review of indoor aerosol generation, transport, and control in the context of COVID-19. International Forum of Allergy & Rhinology, 2020, doi:10.1002/alr.22661.
[9] Leonardo Setti, Fabrizio Passarini, Gianluigi De Gennaro, Pierluigi Barbieri, Maria Grazia Perrone, Massimo Borelli, Jolanda Palmisani,
Alessia Di Gilio, Prisco Piscitelli, and Alessandro Miani. | Air-
borne Transmission Route of COVID-19: | Why 2 Meters/6 Feet
of Inter-Personal Distance Could Not Be Enough. | International

33

Journal of Environmental Research and Public Health, 17(8), 2020, doi:10.3390/ijerph17082932.

[10] N. W. Furukawa, J. T. Brooks, and J. Sobel. Evidence Supporting Transmission of Severe Acute Respiratory Syndrome Coronavirus 2 While Presymptomatic or Asymptomatic. Emerg Infect Dis., 2020, doi:10.3201/eid2607.201595.
[11] Kaiyuan Sun, Wei Wang, Lidong Gao, Yan Wang, Kaiwei Luo, Lingshuang Ren, Zhifei Zhan, Xinghui Chen, Shanlu Zhao, Yiwei Huang, Qianlai Sun, Ziyan Liu, Maria Litvinova, Alessandro Vespignani, Marco Ajelli, Cécile Viboud, and Hongjie Yu. Transmission heterogeneities, kinetics, and controllability of sars-cov-2. Science, 2020, doi:10.1126/science.abe2424.
[12] Hua Qian, Te Miao, Li LIU, Xiaohong Zheng, Danting Luo, and
Yuguo Li. | Indoor transmission of SARS-CoV-2. | medRxiv, 2020,
doi:10.1101/2020.04.04.20053058.
[13] Jan M. Brauner, Sören Mindermann, Mrinank Sharma, David Johnston, John Salvatier, Tomáš Gavenčiak, Anna B. Stephenson, Gavin Leech, George Altman, Vladimir Mikulik, Alexander John Norman, Joshua Teperowski Monrad, Tamay Besiroglu, Hong Ge, Meghan A. Hartwick, Yee Whye Teh, Leonid Chindelevitch, Yarin Gal, and Jan Kulveit. Inferring the effectiveness of government interventions against COVID-19. Science, 2020, doi:10.1126/science.abd9338.
[14] Jeremy Howard, Austin Huang, Zhiyuan Li, Zeynep Tufekci, Vladimir Zdimal, Helene-Mari van der Westhuizen, Arne von Delft, Amy Price, Lex Fridman, Lei-Han Tang, Viola Tang, Gregory L. Watson, Christina E. Bax, Reshama Shaikh, Frederik Questier, Danny Hernandez, Larry F. Chu, Christina M. Ramirez, and Anne W. Rimoin. An evidence review of face masks against COVID-19. Proceedings of the National Academy of Sciences, 118(4), 2021, doi:10.1073/pnas.2014564118.
[15] Rajat Mittal, Rui Ni, and Jung-Hee Seo. The flow physics of COVID-19. Journal of Fluid Mechanics, 894:F2, 2020, doi:10.1017/jfm.2020.330.
[16] N. v. Doremalen, T. Bushmaker, D. H. Morris, M. G. Holbrook, A. Gamble, B. N. Williamson, A. Tamin, J. L. Harcourt, N. J. Thornburg, S. I. Gerber, J. O. Lloyd-Smith, E. de Witt, and V. J. Munster. Aerosol and Surface Stability of SARS-CoV-2 as Compared with SARS-CoV-1. N. Engl. J. Med., 382:1564–1567, 2020, doi:10.1056/NEJMc2004973.
| 34

[17] X. Zhang, J. Zheng, Y. Yue, H. Lui, and J. Wang. Infection Risk Assessment of COVID-19 through Aerosol Transmission: a Case Study of South China Seafood Market. Environmental science & technology, 2020, doi:10.1021/acs.est.0c02895.
[18] Yuguo Li, Hua Qian, Jian Hang, Xuguang Chen, Ling Hong, Peng Liang, Jiansen Li, Shenglan Xiao, Jianjian Wei, Li Liu, and Min Kang. Evidence for probable aerosol transmission of SARS-CoV-2 in a poorly ventilated restaurant. medRxiv, 2020, doi:10.1101/2020.04.16.20067728.
[19] Shelly L Miller, William W Nazaroff, Jose L Jimenez, Atze Boerstra, Giorgio Buonanno, Stephanie J Dancer, Jarek Kurnitski, Linsey C Marr, Lidia Morawska, and Catherine Noakes. Transmission of SARS-CoV-2 by inhalation of respiratory aerosol in the Skagit Valley Chorale superspreading event. medRxiv, 2020, doi:10.1101/2020.06.15.20132027.
[20] George A. Soper. The Lessons of the Pandemic. Science, 49:501, 1919, doi:10.1126/science.49.1274.501.
[21] A. Hartmann and M. Kriegel. Risk assessment of aerosols loaded with virus based on CO2-concentration. Preprint server of the Technische Universität Berlin, 2020, doi:10.14279/depositonce-10362.
[22] Rajesh K. Bhagat, M. S. Davies Wykes, Stuart B. Dalziel, and P. F. Linden. Effects of ventilation on the indoor spread of COVID-19. Journal of Fluid Mechanics, 903:F1, 2020, doi:10.1017/jfm.2020.720.
[23] A. Voß, A. Gritzki, and K. Bux. Infektionsschutzgerechtes Lüften – Hinweise und Maßnahmen in Zeiten der SARS-CoV-2-Epidemie. Bundesanstalt für Arbeitsschutz und Arbeitsmedizin (BAuA), 2020, doi:10.21934/baua:fokus20200918.
[24] Federal Ministry of Labour and Social Affairs Germany. Website: Empfehlung der Bundesregierung “Infektionsschutzgerechtes Lüften” (version 2020-09-16). https://www.bmas.de/SharedDocs/Downloads/DE/Thema-Arbeitsschutz/infektionsschutzgerechtes-lueften. html. (https://www.bmas.de/SharedDocs/Downloads/DE/Thema-Arbeitsschutz/infektionsschutzgerechtes-lueften.html)
[25] Robert | Koch | Institut. | Präventionsmaßnahmen | in | Schulen
während | der | COVID-19-Pandemie. | Empfehlungen | des | Robert
Koch-Instituts | für | Schulen. | (version | 2020-10-12). | https:
//www.rki.de/DE/Content/InfAZ/N/Neuartiges_Coronavirus/ Praevention-Schulen.pdf?__blob=publicationFile. (https://www.rki.de/DE/Content/InfAZ/N/Neuartiges_Coronavirus/Praevention-Schulen.pdf?__blob=publicationFile)

35

[26] Chun-Ru Du, Shun-Chih Wang, Ming-Chih Yu, Ting-Fang Chiu, Jann-Yuan Wang, Pei-Chun Chuang, Ruwen Jou, Pei-Chun Chan, and Chi-Tai Fang. Effect of ventilation improvement during a tuberculosis outbreak in underventilated university buildings. Indoor Air, 30(3):422–432, 2020, doi:10.1111/ina.12639.
[27] NALTIC Industrials, LLC. Aranet4 CO2 Meter. https://naltic.com/aranet4-co2.html#. (https://naltic.com/aranet4-co2.html#)
[28] TFA | Dostmann. | AIRCO2NTROL. | https://www.
tfa-dostmann.de/en/produkte/professional-usage-16/ measuring-instruments-for-professional-usage/ co2-measuring-instruments/. (https://www.tfa-dostmann.de/en/produkte/professional-usage-16/measuring-instruments-for-professional-usage/co2-measuring-instruments/)
[29] Wöhler Technik GmbH. CO2 Messgerät. https://www.woehler.de/shop/co2-messgeraet.html. (https://www.woehler.de/shop/co2-messgeraet.html)
[30] B. Watzka and R. Girwidz. Ist die Luft zu schlecht zum Lernen? Nichtdispersive IR-CO2-Gassensoren im Physikunterricht. Physik und Didaktik in Schule und Hochschule, 10:22–33, 2011.
[31] Hochschule Trier Umwelt-Campus Birkenfeld. Website: COVID-19 Prävention: CO2-Messung und bedarfsorientierte Lüftung (accessed: 2020-09-13). https://www.umwelt-campus.de/forschung/projekte/iot-werkstatt/ideen-zur-corona-krise. (https://www.umwelt-campus.de/forschung/projekte/iot-werkstatt/ideen-zur-corona-krise)
[32] hackster.io (user Brian Boyles). Website: Homemade CO2 Sensor Unit (accessed: 2020-09-13). https://www.hackster.io/bfboyles/homemade-co2-sensor-unit-22a9d8. (https://www.hackster.io/bfboyles/homemade-co2-sensor-unit-22a9d8)
[33] Arduino Forum (user metropol). Website: Arduino Forum: CO2 level classroom sensor (accessed: 2020-09-13). https://forum.arduino.cc/index.php?topic=702131. (https://forum.arduino.cc/index.php?topic=702131)
[34] Home Assistant Forum (user Ombra). | Website: | CO2 mon-
itoring | with | SCD30 | sensor | and | HA | integration | (accessed:
2020-09-13). | https://community.home-assistant.io/t/
co2-monitoring-with-scd30-sensor-and-ha-integration/216708. (https://community.home-assistant.io/t/co2-monitoring-with-scd30-sensor-and-ha-integration/216708)
[35] Raspberry | Pi | Forum | (user | Zentris). | Website: | In | En-
twicklung: | Co2-Sensor | (SCD30) | mit | ESP8266 | und | Dis-
play | SSD1306 | (kurze | Vorstellung) | (accessed: | 2020-09-
13). | https://forum-raspberrypi.de/forum/thread/
44717-in-entwicklung-co2-sensor-scd30-mit-esp8266-und-display-ssd1306-kurze-vorstellun/. (https://forum-raspberrypi.de/forum/thread/44717-in-entwicklung-co2-sensor-scd30-mit-esp8266-und-display-ssd1306-kurze-vorstellun/)

36

[36] Kaspar Metz. CorO2Sens. https://github.com/kmetz/coro2sens, 2020.
[37] Netzbasteln. | Co2narienvogel. | https://github.com/netzbasteln/
co2narienvogel, (https://github.com/netzbasteln/co2narienvogel) 2020.
[38] paulvha. | paulvha SCD30 library. | https://github.com/paulvha/
scd30, (https://github.com/paulvha/scd30) 2020.
[39] Nikolai Ruhe. Website: Infektometer - Ein CO2 Messgerät zur Infektionskontrolle in der Schule (accessed: 2020-11-25). http://infektometer.com/. (http://infektometer.com/)
[40] Guido Burger, Richard Fix, and Klaus-Uwe Gollmer. Der CO2-Warner für die Schule. Make Magazin, 2020. https://www.heise.de/select/make/2020/5/2022015381334973804. (https://www.heise.de/select/make/2020/5/2022015381334973804)
[41] Sensirion: | The Sensor Company. | Datasheet Sensirion SCD30
Sensor Module (Version 0.94). | https://www.sensirion.com/
fileadmin/user_upload/customers/sensirion/Dokumente/9.5_ CO2/Sensirion_CO2_Sensors_SCD30_Datasheet.pdf. (https://www.sensirion.com/fileadmin/user_upload/customers/sensirion/Dokumente/9.5_CO2/Sensirion_CO2_Sensors_SCD30_Datasheet.pdf)
[42] SparkFun Electronics. SparkFun SCD30 CO2 Sensor Library. https: //github.com/sparkfun/SparkFun_SCD30_Arduino_Library, 2020.
[43] The Arduino team. Software: The open-source Arduino IDE. https: //www.arduino.cc/en/main/software.
[44] Ventilation The Federation of European Heating and Air Conditioning associations (REHVA). Website: REHVA COVID-19 guidance document (version 2020-08-03). hhttps://www.rehva.eu/activities/covid-19-guidance/rehva-covid-19-guidance.
[45] Federal | Ministry | of | Labour | and | Social | Affairs | Germany.
Website: | SARS-CoV-2-Arbeitsschutzregel | (version | 2020-08-
20). | https://www.bmas.de/DE/Presse/Meldungen/2020/
neue-sars-cov-2-arbeitsschutzregel.html. (https://www.bmas.de/DE/Presse/Meldungen/2020/neue-sars-cov-2-arbeitsschutzregel.html)
[46] National Oceanic and Atmospheric Administration (NOAA). Website: Earth System Research Laboratory (accessed: 2020-09-28). https://www.esrl.noaa.gov/gmd/ccgg/trends/.
[47] NodeMCU. Website: NodeMCU Documentation (accessed: 2020-09-18). https://nodemcu.readthedocs.io/en/master/.
| | | 37

[48] Kate Connolly. Germans embrace fresh air to ward off coronavirus. The Guardian, 09 2020.
[49] heise online: Verena Stahmer. Website: CO2-Ampel: Erfahrungsbericht aus der Schule (accessed: 2020-11-25). https://www.heise.de/news/CO2-Ampel-Erfahrungsbericht-aus-der-Schule-4932471.html. (https://www.heise.de/news/CO2-Ampel-Erfahrungsbericht-aus-der-Schule-4932471.html)
[50] Sensirion: The Sensor Company. | Design-In guidelines for SCD30
(Version | 0.2). | https://www.sensirion.com/fileadmin/user_
upload/customers/sensirion/Dokumente/9.5_CO2/Sensirion_CO2_ Sensors_SCD30_Assembly_Guideline.pdf. (https://www.sensirion.com/fileadmin/user_upload/customers/sensirion/Dokumente/9.5_CO2/Sensirion_CO2_Sensors_SCD30_Assembly_Guideline.pdf)
[51] G. Chiesa, S. Cesari, M. Garcia, M. Issa, and S. Li. Multisensor IoT Platform for Optimising IAQ Levels in Buildings through a Smart Ventilation System. Sustainability, 1:5777, 2019, doi:10.3390/su11205777.
[52] Song Chen, T. Yamaguchi, and K. Watanabe. A simple, low-cost nondispersive infrared CO2 monitor. 2nd ISA/IEEE Sensors for Industry Conference, 2003, doi:10.1109/SFICON.2002.1159816.
[53] Chih-Hsiung Shen and Jun-Hong Yeah. Long Term Stable ∆ −Σ NDIR Technique Based onTemperature Compensation. Appl. Sci., 9:309, 2019, doi:10.3390/app9020309.
[54] J. Petersen, J. Kristensen, Hagar Elarga, R.K. Andersen, and A. Midtstraum. Accuracy and Air Temperature Dependency of Commercial Low-cost NDIR CO2 Sensors: An Experimental Investigation. In Proceedings of COBEE2018, pages 203–207, 2018.
[55] Sensirion: | The Sensor Company. | Interface Description Sensirion
SCD30 Sensor Module (Version 1.0). https://www.sensirion.com/fileadmin/user_upload/customers/sensirion/Dokumente/9.5_CO2/Sensirion_CO2_Sensors_SCD30_Interface_Description.pdf. (https://www.sensirion.com/fileadmin/user_upload/customers/sensirion/Dokumente/9.5_CO2/Sensirion_CO2_Sensors_SCD30_Interface_Description.pdf)
[56] SparkFun Electronic. Website: Installing an Arduino Library. https://learn.sparkfun.com/tutorials/installing-an-arduino-library.
[57] Alf Köhn-Seemann. CO2 Monitor. https://github.com/alfkoehn/CO2_monitor, (https://github.com/alfkoehn/CO2_monitor) 2020.
[58] Adafruit Industries. | Adafruit SSD1306. | https://github.com/
adafruit/Adafruit_SSD1306, (https://github.com/adafruit/Adafruit_SSD1306) 2020.
[59] johnrickman. LiquidCrystal I2C. https://github.com/johnrickman/LiquidCrystal_I2C, (https://github.com/johnrickman/LiquidCrystal_I2C) 2020.

38

[60] me-no dev. ESPAsyncWebServer. https://github.com/me-no-dev/ESPAsyncWebServer, (https://github.com/me-no-dev/ESPAsyncWebServer) 2020.
[61] me-no dev. ESPAsyncTCP: Async TCP Library for ESP8266 Arduino. https://github.com/me-no-dev/ESPAsyncTCP, 2020.

39
