alfkoehn/CO2_monitor/(threads)

Thread 1 (2020-11-13):

Attention fritzing part is mirrored

ARKopp, 2020-11-13:
fritzing part is mirrored and holes are two small for 1/32 mill.

alfkoehn, 2020-11-13:
Hi, thanks for your feedback but I do not think that the part is mirrored, see page 6 of the datasheet [1], or a photography of mine attached to this post.

Concerning the holes: which holes should have the 1/32 inches in diameter, the two larger ones or the 7 smaller ones (which should have a diameter of 1 mm, see [1]) and do you have a reference for that?

[1] [Datasheet](https://www.mouser.com/datasheet/2/813/Sensirion_CO2_Sensors_SCD30_Preliminary-Datasheet-1516638.pdf)

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

ARKopp, 2020-11-13:
in the picture you soldered the pins on the wrong side. I think the
SENSIRION writing should be on top and also if you do it like you dit  way
cannot see the LED blinking.

The larger holes should be a bit bigger.

Am Fr., 13. Nov. 2020 um 11:20 Uhr schrieb Alf Köhn-Seemann <
notifications@github.com>:

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

ARKopp, 2020-11-13:
also there should be copper rings on both sides. in your version its only on on side.

alfkoehn, 2020-11-13:
> in the picture you soldered the pins on the wrong side. I think the SENSIRION writing should be on top and also if you do it like you did you cannot see the LED blinking. Why a led if its facing towards the PCB?
So you would prefer a drawing according to the photo attached to this post, I also thought about doing this, but since the pins were only labeled on the other side of the sensor, I decided to use this.

The argument to do it as you suggested is that this side also has the air inlets, so this is the side which should be place somewhere such that it is well exposed to the ambient air. (Note that the light you see is actually not an LED, I also thought this first, but according to my research, it rather seems to be a light bulb since this is a nice and cheap source for IR light).

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

> The larger holes should be a bit bigger.
My starting point were the STEP files provided by the manufacturer. I might have messed something up while ex- and importing the file around, but I am curious how to you know about the dimension for the holes (sorry if this is an obvious question for you) ?

ARKopp, 2020-11-13:
the label of the pins is on the bottom because there is no space on top.
the top is definitely where the light and the opening of the sensor is.
Also there a these little two pins on the botton so the sensor is not in
the air.

I know the side of the holes because I have a pcb mill and when I load it
into the program from Bantam Tools the wholes cannot be milled with a 1/32
mill. You could also check this in DRC.

Am Fr., 13. Nov. 2020 um 13:07 Uhr schrieb Alf Köhn-Seemann <
notifications@github.com>:

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

alfkoehn, 2020-11-13:
> the top is definitely where the light and the opening of the sensor is.

Looking at the Datasheet document mentioned above, I think I now remember why I have chosen to draw this side: it is actually labelled as top view there. Which is a bit unfortunate, as it can indeed result in installations where the bottom side (according to the document) might be very close to some board which would be problematic for the sensor as the openings for the air, and also the temperature sensor, are located at this bottom side.

> I know the side of the holes because I have a pcb mill and when I load it into the program from Bantam Tools the holes cannot be milled with a 1/32 mill. You could also check this in DRC. Also there is almost no copper on the one side where you could solder the pin in.

Sounds like I need to re-make the whole file, as I don't want people to get wrong impressions on how to install the sensor (besides from fixing the hole-diameter and the size of the copper rings).

ber-red, 2020-11-14:
IMHO fritzing part ist not "wrong" but one of two possibilities
As Page 2 of the [Handling and Assembly Guide for SCD30](https://www.sensirion.com/fileadmin/user_upload/customers/sensirion/Dokumente/9.5_CO2/Sensirion_CO2_Sensors_SCD30_Assembly_Guideline.pdf) pointe out "**...SCD30 can be mounted facing upwards or downwards.**"

so from my point of view:  "you have two choices, one is taken, period" ;-).

Thread 3 (2020-11-14):

must wifi be "nailed" to station mode?

ber-red, 2020-11-14:
When i used your .ino,  my esp board connected to my WLAN correctly but showed up as Access point "ESP-nnnnnn" as well.
(to be more specific: i was able to connect to that WLAN without password, port scan shows port 80 open then, but my browser only shows a blank page).

So i started reading some docs.
[Station Class documentation](https://arduino-esp8266.readthedocs.io/en/latest/esp8266wifi/station-class.html) says
"Switching the module to Station mode is done with `begin` function"

This corrosponds with your code `WiFi.begin()`
but later the doc says
...
"... It is possible that calling `begin` will result in the module being in STA + softAP mode if the module was previously placed into AP mode."

I assume this is the effect i ran into (board was brand-new, never used it before).
reading [this](https://arduino-esp8266.readthedocs.io/en/latest/esp8266wifi/generic-class.html#mode) i added an additional line

`WiFi.mode(WIFI_STA)`

After compiling and installing this i do not see the ESP-nnnnnn Access point anymore.

As i am not very familiar with coding nor am i sure if this is a general issue or just an "Einzelfall" and my "solution" ist correct, please have a look at it and let me know.
(I did not try out if the AP reappears if i remove the `WiFi.mode(WIFI_STA)` line later, just left it in my .ino file)

PS: I like your CO2 project very much - was a starting point to get into coding and IOT as well and look forward to your chart.js snippets

alfkoehn, 2020-11-15:
Well spotted, thanks again for your feedback!

Being new to Arduino, I have just learned that one should do as you suggested (explicitly setting the esp8266 to be a wifi client), and I have already used that in another project, but completely forgotten to include it here, will do so now! Thanks :)

Closed 2020-11-15.
