alfkoehn/CO2_monitor/(commit log)

2020-09-22 add pre-processor switch for WiFi support
2020-11-09 add calibration functions for SCD30
2020-11-14 replace wrong degree symbol (167) with correct one (248)
    [CO2_monitor.ino]
2020-11-18 Major changes: first version of a data logger
    - complete new website
    - load Chart.js from internet to display data charts (1000 values)
    - show table with last 1000 values
    - adapt functions processing data to website
    - note: currently, the graphs is completely replotted when new data
    arrives, this is certainly not optimal
    there is probably a way to update the graphs in a better way
2020-11-20 Turn WiFi explicitely off, when not needed (save power)
2020-11-23 Prevent favicon request (no favicon used currently)
2020-11-25 Add info about calibration + update code listings
2020-12-10 Bug fix (thanks to email from W.H.)
    [CO2_monitor.ino]
2020-12-22 Bugfix with new library of SCD30, thanks to C.H.
    [CO2_monitor.ino]
2020-12-22 Adjust code print to changes in code-file
2021-01-27 Fix upper/lower case errors in bib
2021-02-06 Make the warning diode a compile-time option
